SmartMeteo/smartmeteo/artwork/portal_v4.png

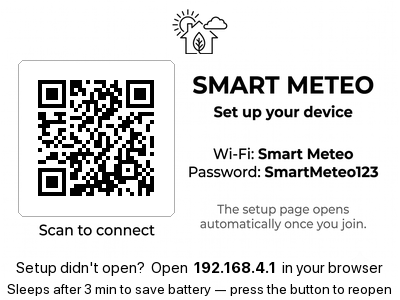
artwork/portal_v4.png
