SmartMeteo/smartmeteo/artwork/weather_v2.png

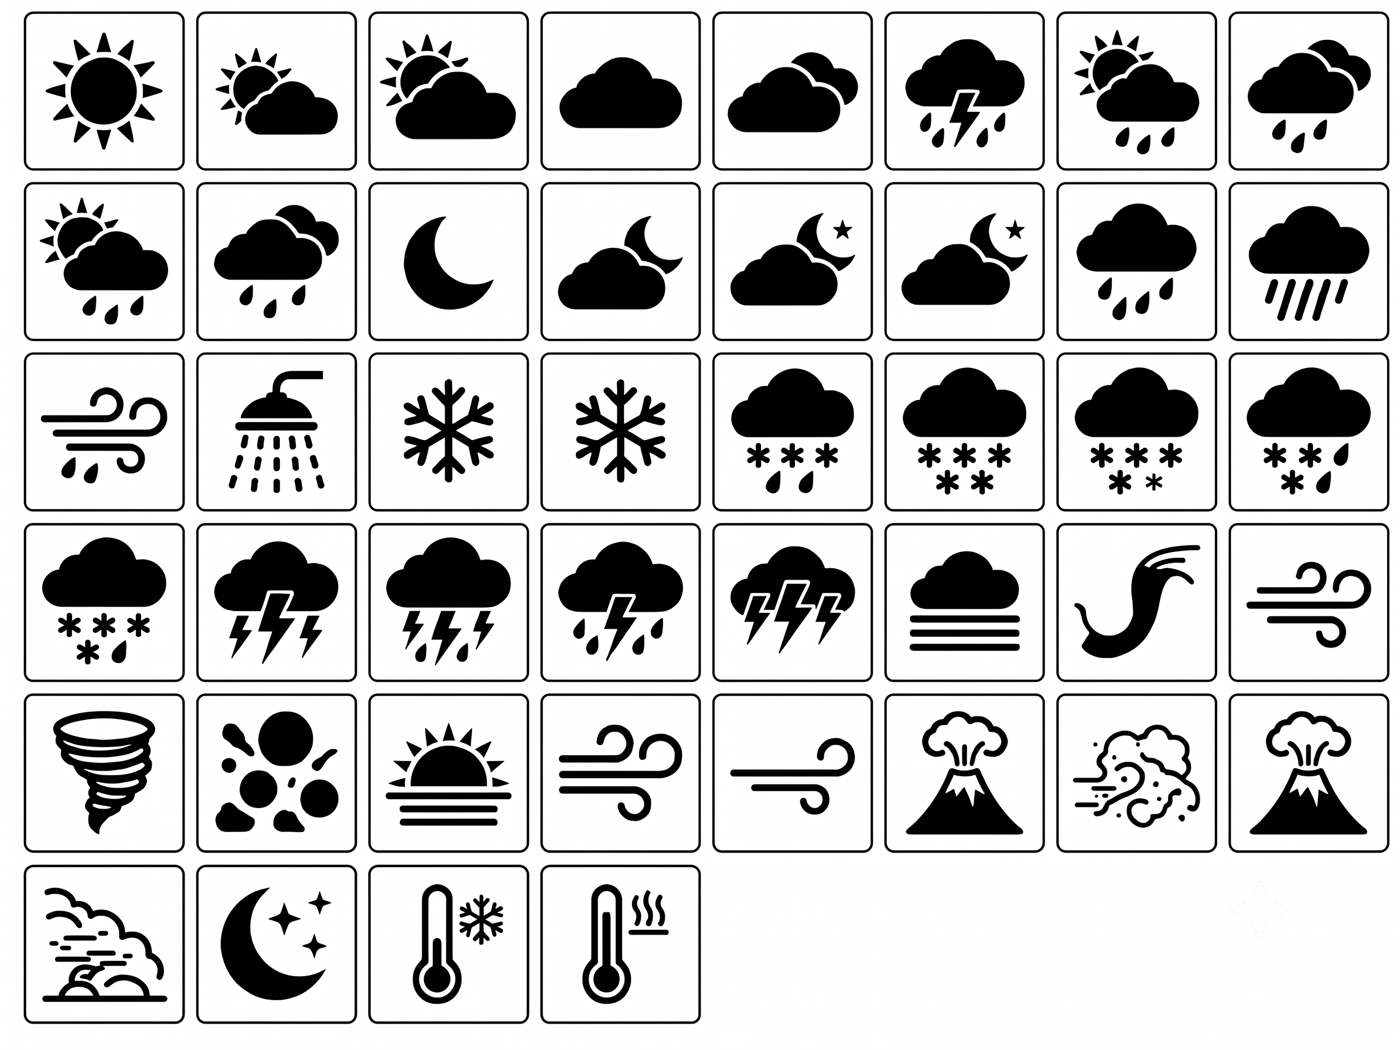
artwork/weather_v2.png
