SmartMeteo/smartmeteo/artwork/wxv2/idx00.png

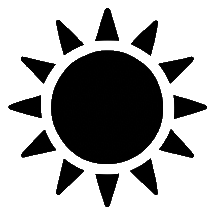
artwork/wxv2/idx00.png
