SmartMeteo/smartmeteo/artwork/wxv2/idx01.png

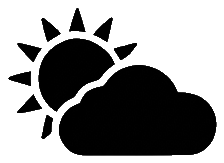
artwork/wxv2/idx01.png
