SmartMeteo/smartmeteo/artwork/wxv2/idx02.png

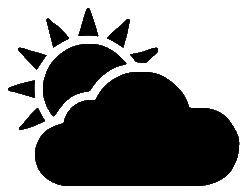
artwork/wxv2/idx02.png
