SmartMeteo/smartmeteo/artwork/wxv2/idx03.png

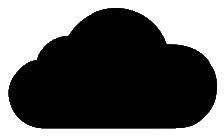
artwork/wxv2/idx03.png
