SmartMeteo/smartmeteo/artwork/wxv2/idx04.png

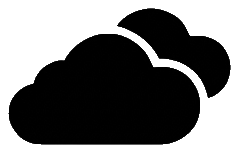
artwork/wxv2/idx04.png
