SmartMeteo/smartmeteo/artwork/wxv2/idx05.png

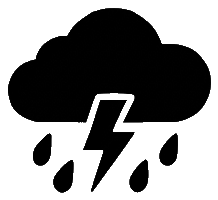
artwork/wxv2/idx05.png
