SmartMeteo/smartmeteo/artwork/wxv2/idx06.png

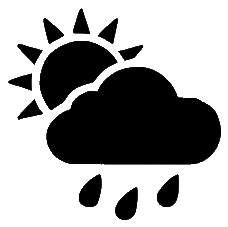
artwork/wxv2/idx06.png
