SmartMeteo/smartmeteo/artwork/wxv2/idx07.png

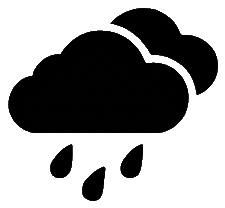
artwork/wxv2/idx07.png
