SmartMeteo/smartmeteo/artwork/wxv2/idx09.png

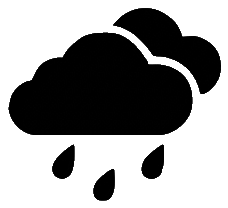
artwork/wxv2/idx09.png
