SmartMeteo/smartmeteo/artwork/wxv2/idx10.png

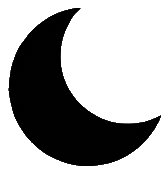
artwork/wxv2/idx10.png
