SmartMeteo/smartmeteo/artwork/wxv2/idx11.png

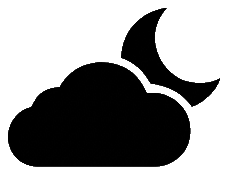
artwork/wxv2/idx11.png
