SmartMeteo/smartmeteo/artwork/wxv2/idx12.png

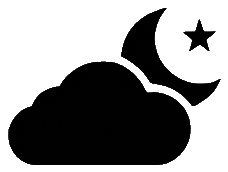
artwork/wxv2/idx12.png
