SmartMeteo/smartmeteo/artwork/wxv2/idx14.png

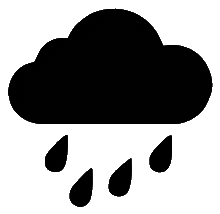
artwork/wxv2/idx14.png
