SmartMeteo/smartmeteo/artwork/wxv2/idx15.png

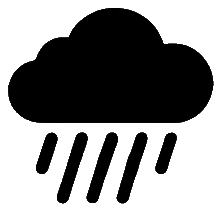
artwork/wxv2/idx15.png
