SmartMeteo/smartmeteo/artwork/wxv2/idx16.png

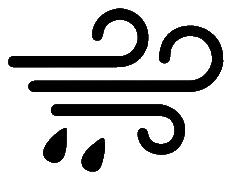
artwork/wxv2/idx16.png
