SmartMeteo/smartmeteo/artwork/wxv2/idx17.png

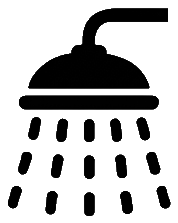
artwork/wxv2/idx17.png
