SmartMeteo/smartmeteo/artwork/wxv2/idx18.png

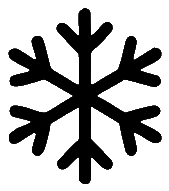
artwork/wxv2/idx18.png
