SmartMeteo/smartmeteo/artwork/wxv2/idx20.png

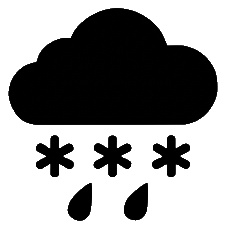
artwork/wxv2/idx20.png
