SmartMeteo/smartmeteo/artwork/wxv2/idx25.png

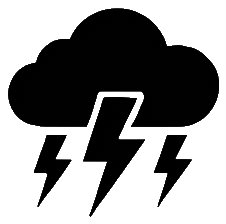
artwork/wxv2/idx25.png
