SmartMeteo/smartmeteo/artwork/wxv2/idx26.png

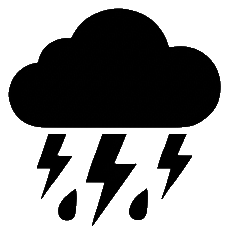
artwork/wxv2/idx26.png
