SmartMeteo/smartmeteo/artwork/wxv2/idx28.png

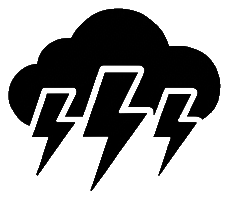
artwork/wxv2/idx28.png
