SmartMeteo/smartmeteo/artwork/wxv2/idx29.png

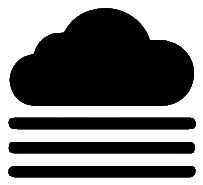
artwork/wxv2/idx29.png
