SmartMeteo/smartmeteo/artwork/wxv2/idx30.png

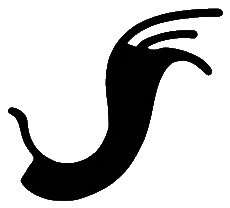
artwork/wxv2/idx30.png
