SmartMeteo/smartmeteo/artwork/wxv2/idx31.png

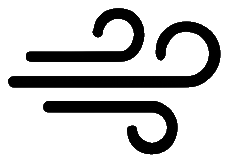
artwork/wxv2/idx31.png
