SmartMeteo/smartmeteo/artwork/wxv2/idx32.png

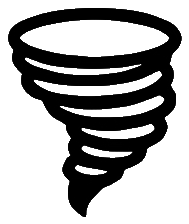
artwork/wxv2/idx32.png
