SmartMeteo/smartmeteo/artwork/wxv2/idx33.png

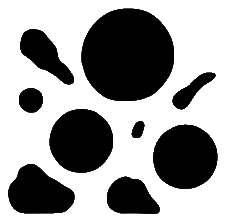
artwork/wxv2/idx33.png
