SmartMeteo/smartmeteo/artwork/wxv2/idx34.png

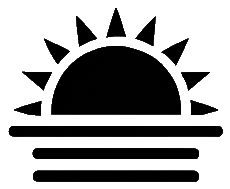
artwork/wxv2/idx34.png
