SmartMeteo/smartmeteo/artwork/wxv2/idx35.png

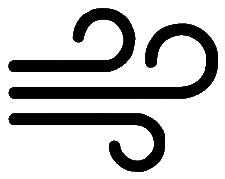
artwork/wxv2/idx35.png
