SmartMeteo/smartmeteo/artwork/wxv2/idx36.png

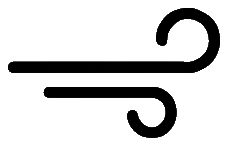
artwork/wxv2/idx36.png
