SmartMeteo/smartmeteo/artwork/wxv2/idx37.png

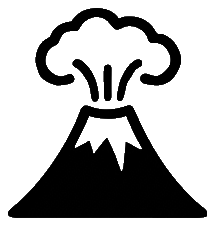
artwork/wxv2/idx37.png
