SmartMeteo/smartmeteo/artwork/wxv2/idx38.png

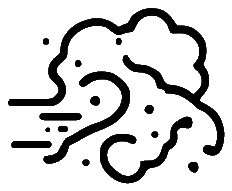
artwork/wxv2/idx38.png
