SmartMeteo/smartmeteo/artwork/wxv2/idx40.png

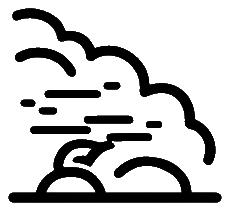
artwork/wxv2/idx40.png
