SmartMeteo/smartmeteo/artwork/wxv2/idx41.png

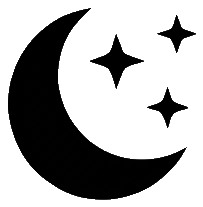
artwork/wxv2/idx41.png
