SmartMeteo/smartmeteo/artwork/wxv2/idx42.png

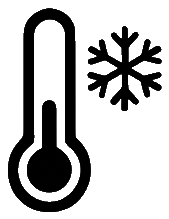
artwork/wxv2/idx42.png
