SmartMeteo/smartmeteo/artwork/wxv2/idx43.png

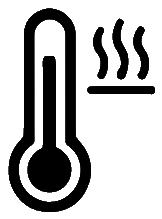
artwork/wxv2/idx43.png
