SmartMeteo/smartmeteo/hardware/board-v2/SmartMeteo-v2.2_BOM.csv

ID | Name | Designator | Footprint | Quantity | Manufacturer Part | Manufacturer | Supplier | Supplier Part | Price
1 | HX TS-1088-AR02016 | BOOT,RESET | SW-SMD_L4.0-W2.9-LS5.0 | 2 | HX 3x4x2-2P-2.5N | hanxia(韩下) | LCSC | C36498961 | 0.026
2 | 1uF | C1,C4,C6,C7,C23,C24,C25,C27,C28,C29,C30,C31 | C0805 | 12 | CL21B105KBFNNNE | SAMSUNG(三星) | LCSC | C28323 | 0.043
3 | 10uF | C2,C3,C5,C19,C20 | C0805 | 5 | CL21A106KAYNNNE | SAMSUNG(三星) | LCSC | C15850 | 0.04
4 | 22pF | C8,C11 | C0805 | 2 | CL21C220JBANNNC | SAMSUNG(三星) | LCSC | C1804 | 0.012
5 | 100nF | C9,C10 | C0805 | 2 | CC0805KRX7R9BB104 | YAGEO(国巨) | LCSC | C49678 | 0.021
6 | 4.7uF | C21,C33 | C0805 | 2 | CL21A475KAQNNNE | SAMSUNG(三星) | LCSC | C1779 | 0.035
7 | 22uF | C32 | C0805 | 1 | CL21A226MAQNNNE | SAMSUNG(三星) | LCSC | C45783 | 0.185
8 | S2B-PH-SM4-TB(LF)(SN) | CN1 | CONN-SMD_P2.00_S2B-PH-SM4-TB-LF-SN | 1 | S2B-PH-SM4-TB(LF)(SN) | JST | LCSC | C295747 | 0.228
9 | PESD5V0S1BA,115 | D1 | SOD-323_L1.7-W1.3-LS2.5-BI | 1 | PESD5V0S1BA,115 | Nexperia(安世) | LCSC | C19224 | 0.074
10 | TPD2E009DBZR_C2871371 | D2 | SOT-23-3_L2.9-W1.3-P1.90-LS2.4-BR | 1 | TPD2E009DBZR | TI(德州仪器) | LCSC | C2871371 | 0.318
11 | B5819W_C8598 | D3,D4,D5,D6 | SOD-123_L2.7-W1.6-LS3.7-RD-1 | 4 | B5819W SL | CJ(江苏长电/长晶) | LCSC | C8598 | 0.027
12 | 47uH | L1 | IND-SMD_L4.5-W4.0 | 1 | CD43-470M 47UH | DMBJ(振宝佳) | LCSC | C2826648 | 0.036
13 | 0805G (Green) | LED1 | LED0805-R-RD | 1 | KT-0805G | KENTO | LCSC | C2297 | 0.017
14 | 17-21SUYC/TR8 | LED2 | LED0805-R-RD | 1 | KT-0805黄灯 | KENTO | LCSC | C2296 | 0.013
15 | FPC 0.5MM 24P Pull type H2.0mm Pick up | P2 | FPC-SMD_24P-L17.5-W5.4-P0.50 | 1 | AFC07-S24ECC-00 | JS(钜硕电子) | LCSC | C11092 | 0.098
16 | AO3400A | Q1,Q2 | SOT-23-3_L2.9-W1.3-P1.90-LS2.4-BR | 2 | AO3400A | AOS | LCSC | C20917 | 0.09
17 | AO3401A | Q3,Q4 | SOT-23_L2.9-W1.3-P1.90-LS2.4-BR | 2 | AO3401A | AOS | LCSC | C15127 | 0.084
18 | XC6220B331MR-G | Q5 | SOT-25_L3.0-W1.6-P0.95-LS2.8-TL | 1 | XC6220B331MR-G | TOREX(特瑞仕) | LCSC | C86534 | 0.48
19 | 5.1kΩ | R1,R5 | R0805 | 2 | 0805W8F5101T5E | UNI-ROYAL(厚声) | LCSC | C27834 | 0.006
20 | 22Ω | R2,R4 | R0805 | 2 | 0805W8F220JT5E | UNI-ROYAL(厚声) | LCSC | C17561 | 0.005
21 | 4.7kΩ | R3,R22 | R0805 | 2 | 0805W8F4701T5E | UNI-ROYAL(厚声) | LCSC | C17673 | 0.004
22 | 10kΩ | R6,R10,R11,R14,R15,R16,R21 | R0805 | 7 | 0805W8F1002T5E | UNI-ROYAL(厚声) | LCSC | C17414 | 0.003
23 | 1.2kΩ | R7 | R0805 | 1 | 0805W8F1201T5E | UNI-ROYAL(厚声) | LCSC | C17379 | 0.005
24 | 100kΩ | R8 | R0805 | 1 | 0805W8F1003T5E | UNI-ROYAL(厚声) | LCSC | C149504 | 0.006
25 | 1MΩ | R9,R17 | R0805 | 2 | 0805W8F1004T5E | UNI-ROYAL(厚声) | LCSC | C17514 | 0.004
26 | 390kΩ | R12 | R0805 | 1 | RT0805BRD07390KL | YAGEO(国巨) | LCSC | C865444 | 0.044
27 | 1kΩ | R18,R20 | R0805 | 2 | 0805W8F1001T5E | UNI-ROYAL(厚声) | LCSC | C17513 | 0.004
28 | 2.2Ω | R19 | R0805 | 1 | 0805W8F220KT5E | UNI-ROYAL(厚声) | LCSC | C17521 | 0.006
29 | 1MΩ | R23 | R0805 | 1 | RT0805BRD071ML | YAGEO(国巨) | LCSC | C706228 | 0.073
30 | GT-TC018A-H0375-L1 | SW2 | SW-SMD_L4.7-W3.5-P3.35-EH | 1 | GT-TC018A-H0375-L1 | G-Switch(品赞) | LCSC | C963235 | 0.063
31 | SCD41-D-R2 | U3 | LGA-20_L10.1-W10.1-P1.25-TL | 1 | SCD41-D-R2 | Sensirion(瑞士盛思锐) | LCSC | C3659294
32 | M2 INSERT 4MM | U5,U7,U12,U13 | M2 4MM SMT INSERT | 4 | SMTSO2040CTJ | Sinhoo(雄和远景) | LCSC | C2916349 | 0.088
33 | ESP32-C6-WROOM-1-N8 | U6 | WIRELM-SMD_ESP32-C6-WROOM-1 | 1 | ESP32-C6-WROOM-1-N8 | ESPRESSIF(乐鑫) | LCSC | C5366877 | 4.34
34 | TP4056 | U8 | ESOP-8_L4.9-W3.9-P1.27-LS6.0-BL-EP | 1 | TP4056-42-ESOP8 | TOPPOWER(南京拓微) | LCSC | C16581 | 0.187
35 | 3.7V 2000MAH 54×35 | U9 | LIPO-103450_2000MAH_54X35 | 1 |  |  | aliexpress
36 | BME690 | U10 | LGA-8_L3.0-W3.0-P0.80-TR-1 | 1 | BME690 | Bosch(博世) | LCSC | C42431867 | 10.012
37 | HX TYPE-C 16PIN | U11 | TYPE-C-SMD_HX-TYPE-C-16PIN | 1 | HX TYPE-C 16PIN | hanxia(韩下) | LCSC | C5178539 | 0.076
38 | 32.768kHz | X1 | FC-135R_L3.2-W1.5 | 1 | Q13FC13500004 | EPSON(爱普生) | LCSC | C32346 | 0.173
