SmartMeteo/smartmeteo/hardware/enclosure/release_v2.2/pla/stl/stand_flap.stl

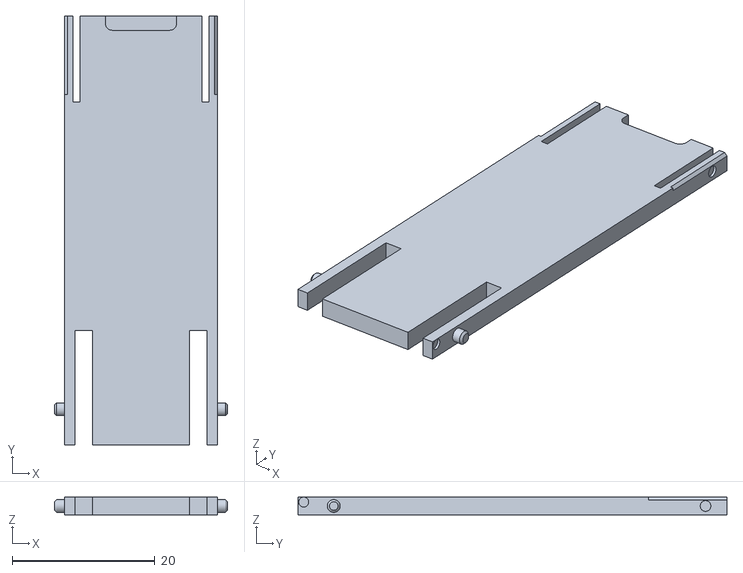
[picture p40: CAD file, 2026-11-04]
hardware/enclosure/release_v2.2/pla/stl/stand_flap.stl
24.2 x 60.0 x 2.50
