SmartMeteo/smartmeteo/hardware/enclosure/release_v2.2/pla/stl/key.stl

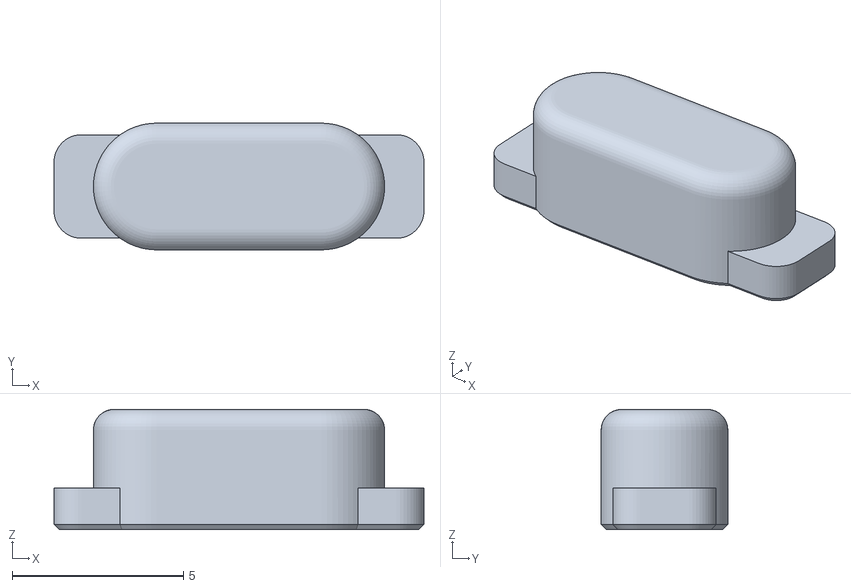
[picture p42: CAD file, 2026-11-04]
hardware/enclosure/release_v2.2/pla/stl/key.stl
10.8 x 3.70 x 3.51
