SmartMeteo/smartmeteo/hardware/enclosure/release_v2.2/pla/stl/front_shell.stl

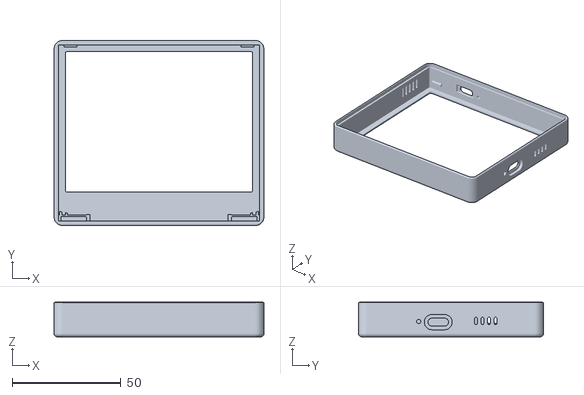
[picture p44: CAD file, 2026-11-04]
hardware/enclosure/release_v2.2/pla/stl/front_shell.stl
96.4 x 84.9 x 15.9
