SmartMeteo/smartmeteo/hardware/enclosure/release_v2.2/sla/step/rear_cover.step

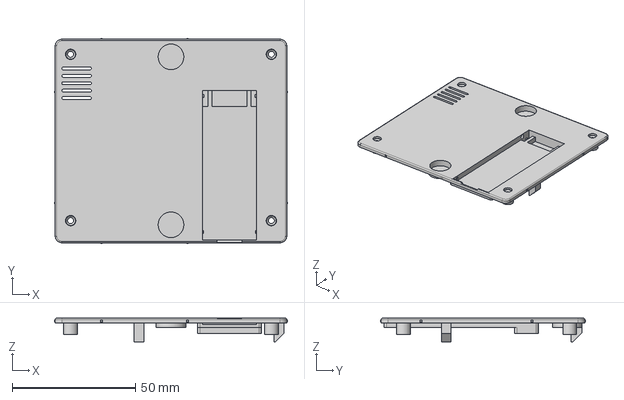
[picture p45: CAD file, 2026-11-04]
hardware/enclosure/release_v2.2/sla/step/rear_cover.step
94.5 x 83.1 x 9.69 mm
