SmartMeteo/smartmeteo/hardware/enclosure/release_v2.2/pla/stl/jig_base.stl

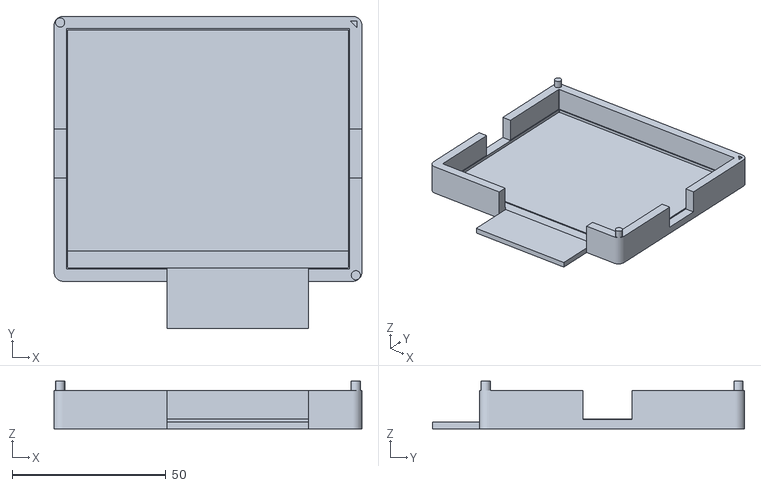
[picture p46: CAD file, 2026-11-04]
hardware/enclosure/release_v2.2/pla/stl/jig_base.stl
100.2 x 101.6 x 15.6
