SmartMeteo/smartmeteo/hardware/enclosure/release_v2.2/sla/step/key_c030.step

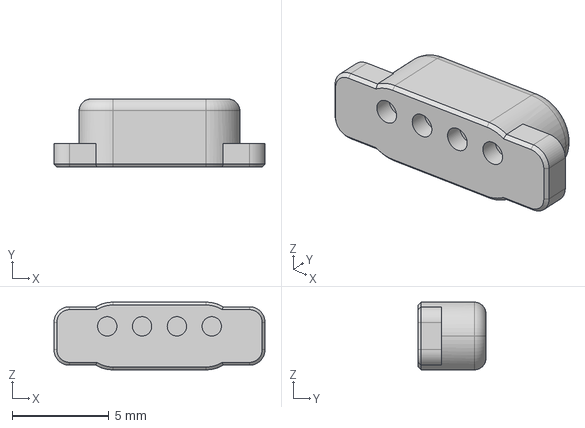
[picture p47: CAD file, 2026-11-04]
hardware/enclosure/release_v2.2/sla/step/key_c030.step
10.9 x 3.51 x 3.50 mm
