SmartMeteo/smartmeteo/hardware/enclosure/release_v2.2/pla/stl/rear_cover.stl

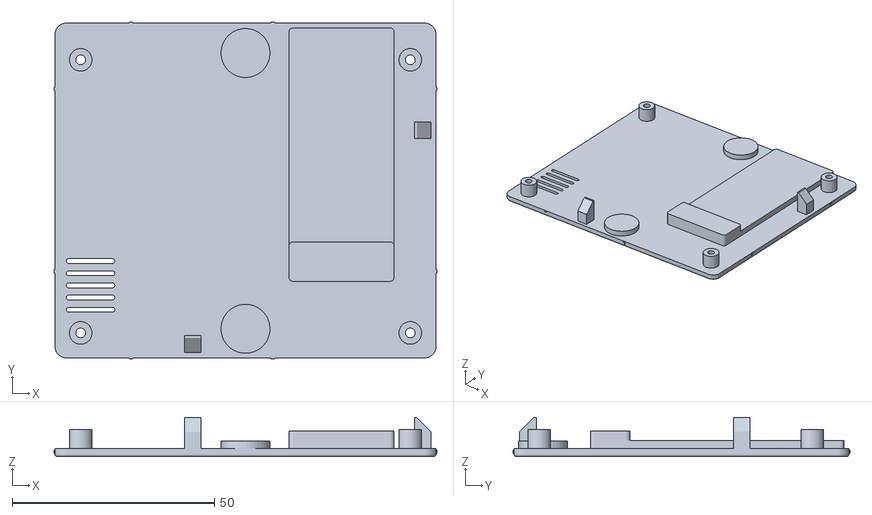
[picture p48: CAD file, 2026-11-04]
hardware/enclosure/release_v2.2/pla/stl/rear_cover.stl
94.6 x 83.1 x 9.69
