SmartMeteo/smartmeteo/hardware/enclosure/release_v2.2/pla/stl/jig_lid.stl

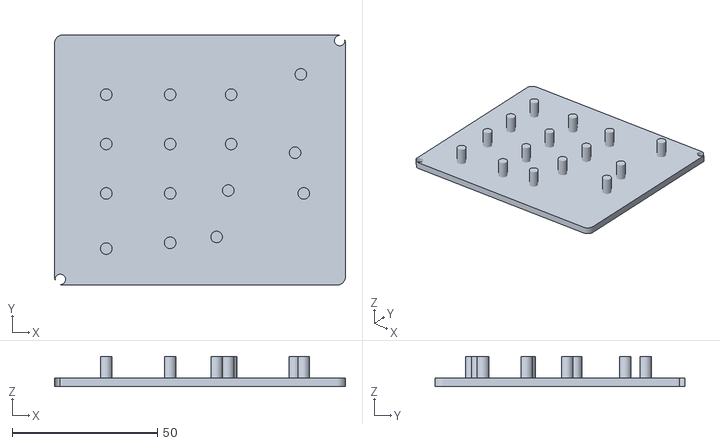
[picture p49: CAD file, 2026-11-04]
hardware/enclosure/release_v2.2/pla/stl/jig_lid.stl
100.2 x 86.2 x 10.4
