SmartMeteo/smartmeteo/hardware/enclosure/release_v2.2/sla/step/key_c025.step

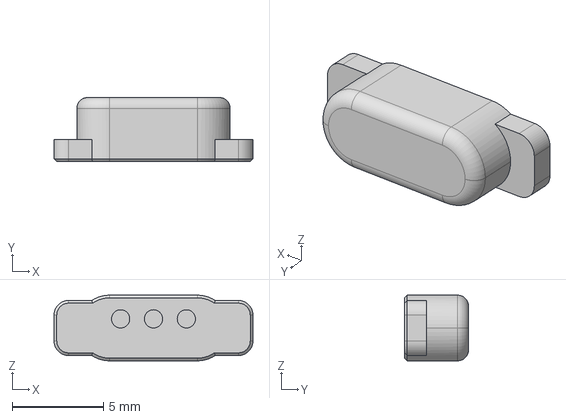
[picture p50: CAD file, 2026-11-04]
hardware/enclosure/release_v2.2/sla/step/key_c025.step
10.9 x 3.51 x 3.60 mm
