SmartMeteo/smartmeteo/(list of files, cad)

Other CAD files:
hardware/enclosure/release_v2.2/sla/step/key.step
hardware/enclosure/release_v2.2/sla/step/stand_flap.step
hardware/enclosure/release_v2.2/sla/step/front_shell.step
hardware/enclosure/release_v2.2/sla/stl/front_shell.stl
hardware/enclosure/release_v2.2/sla/stl/key.stl
hardware/enclosure/release_v2.2/sla/stl/key_c010.stl
hardware/enclosure/release_v2.2/sla/stl/key_c015.stl
hardware/enclosure/release_v2.2/sla/stl/key_c025.stl
hardware/enclosure/release_v2.2/sla/stl/key_c030.stl
hardware/enclosure/release_v2.2/sla/stl/rear_cover.stl
hardware/enclosure/release_v2.2/sla/stl/stand_flap.stl
