SmartMeteo/smartmeteo/firmware/tests/README.md

# Автотесты Smart Meteo

Одной командой, без ESP-IDF и без прибора:

```bash
Software/ESP-IDF/tests/run.sh
```

Нужны `c++` (Apple clang) и `python3`; для браузерного набора — node и playwright (ниже). Проверки
собирают **исходники прошивки**, а не их копии: если тест расходится с прибором, значит изменился
прибор.

## Что проверяется

| Набор | Что именно | Как |
|---|---|---|
| `t_analytics` | классы Bosch и их границы, каскад `classifyAir`, гистерезис CO₂ и влажности, точка росы, пороги тенденции Met Office, уровни тревог | компилирует настоящий `analytics.cpp` |
| `t_weather` | таблица символов MET, разбор дат и заголовка `Expires`, сводка по дням, выбор иконки, **весь путь `Weather::met`** на подставленном ответе | компилирует `weather.cpp` целиком, сеть заменена на уровне ESP-IDF |
| `t_cycle` | **расписание пробуждений**: профили и их интервалы, ночное окно через полночь, прибор без сети, пол радио в режиме хаба, ночная парковка панели и правило «замораживающий кадр обязан быть полным», слепой режим без часов, чистящий кадр, опережение к границе минуты, блокировка по разряду и выход из неё на кабеле, снятие источников сна, **оборот кольца истории** — код, не исполнявшийся ни на одном приборе | компилирует **настоящий `bench_screens.cpp`** с заглушками ESP-IDF под ним |
| `t_screen` | десять состояний экрана против утверждённого снимка + инварианты (доля чернил, пароль втрое выше адреса) | `tools/screenhost` — это `screen.cpp` и `epaper.cpp` прибора |
| `t_console` | синтаксис скрипта консоли; каждый путь консоли есть в прошивке и наоборот; **каждый закрытый обработчик спрашивает пароль**; одно правило длины пароля на все места; картинки гида; шаги мастера | разбор `console.html`, `web_server.cpp`, `wifi_manager.*` |
| `t_browser` | вход по паролю, все вкладки, журнал безопасности, гид, мастер целиком; **вёрстка на 320 / 360 / 375 / 1024 px, в том числе на предельных данных**; ни одного исключения в скрипте | настоящий Chromium против `tests/mock.py` |

Итог сейчас: **584 проверки C++** (54 аналитика, 69 погода, 44 экран настройки, 298 солнце и луна,
119 цикл) плюс сверка солнца со второй реализацией, **41 по экрану** (снимки и инварианты),
**179 по консоли**, **129 в браузере** — 933 всего.

## Как это устроено

**Заглушки — под кодом прошивки, а не вместо него.** `stubs/` подменяет заголовки ESP-IDF
(`esp_log.h`, `esp_timer.h`, `esp_http_client.h`), поэтому `Https::Reader` и потоковый разбор —
настоящие. Тело ответа задаёт `HttpStub::body`; `HttpStub::chunk` выдаёт его кусками по N байт, и
разбор, который зависит от границ чтения, падает здесь, а не на приборе.

Заглушать `main/https_client.h` бесполезно: `#include "..."` в кавычках сначала смотрит рядом с
включающим файлом, поэтому настоящий заголовок всё равно побеждает. Это и правильно — подменять
стоит чужой код, а не свой.

### Расписание пробуждений: `t_cycle`

`bench_screens.cpp` был крупнейшим файлом проекта и единственным крупным, которого не касался ни
один тест. Причина уважительная: сон, радио, шину I²C и панель заменить нечем, кроме прибора. Но
**решение отделимо от исполнения** — что мерить, когда выходить в сеть, будет ли кадр полным, на
какой срок засыпать — это арифметика над настройками, часами и состоянием RTC, и она проверяется
здесь.

Заглушки стоят **под** прошивкой, на границе ESP-IDF (`stubs/idf/`), поэтому настоящими остаются не
только четыре функции расписания, но и почти вся прошивка: `nvs_manager.cpp` над эмуляцией NVS
(включая хранение float битовым образом U32), `hist_store.cpp` и `evt_log.cpp` над флешем в ОЗУ,
который умеет только сбрасывать биты — как настоящий, `analytics.cpp`, `sun_moon.cpp`, `screen.cpp`,
`epaper.cpp`, `max17048.cpp` над эмуляцией регистров газомера.

Заглушены на границе **класса** только три, и у каждого причина: `WebServer` и `MqttPublisher` —
выходы цикла, уже покрытые `t_console` и `t_browser`; `MatterMode` — за ним CHIP, которого на этой
машине нет, и он всё равно не уходит в глубокий сон. Отдельно заглушён закрытый алгоритм Bosch
(`libalgobsec.a` собрана под RISC-V) — но **под** настоящим `bsec_manager.cpp`, так что порядок
инициализации, вентиль по `next_call` и арифметика метки времени исполняются как на приборе.

Прошивка для этого **не менялась ни на строку**. Часы перехвачены определением `time()` и
`gettimeofday()` в `stubs/idf/host.cpp`; выход из сна и перезагрузки — броском `HostDeepSleep` и
`HostRestart`. Это тот же класс приёма, что `-Dprivate=public` в `tools/screenhost`.

Чем тест управляет и что читает — `stubs/idf/host.h`: часы, кабель, кнопка, напряжение ячейки,
свободная куча, причина загрузки; обратно — какой таймер вооружён, снимались ли источники, сколько
раз позван `esp_restart()`, и **захваченный лог**, потому что часть решений прошивки видна только в
нём.

**Чего `t_cycle` не проверяет:** что прибор действительно проснулся, что панель действительно
нарисовала, что радио действительно подключилось, и сходится ли индекс Bosch. Это прогон на железе.
Здесь проверяется, что прошивка **решила**, а не что получилось.

**Одно расхождение с прибором, по построению:** на приборе каждое пробуждение — новая загрузка, и
функциональные статики начинаются заново; здесь все случаи идут в одном процессе. В функциях под
проверкой такая одна — `static bool asked` в `plan_tick()`. Ни одна проверка на неё не опирается.

**Санитайзеры включены** (`-fsanitize=address,undefined`). Разбор чужого ответа — ровно то место,
где чтение за буфером стоит ловить на компьютере.

**Снимки экрана** лежат в `golden/*.pbm` (по 15 КБ, открываются просмотрщиком). При расхождении тест
печатает число разошедшихся пикселей и их область. Принять новый вид — **посмотрев на него**:

```bash
Software/ESP-IDF/tests/run.sh --accept
```

**Подставной прибор** — `tests/mock.py`: тот же веб-API, та же аутентификация вызов-ответ и те же
заголовки, что шлёт прошивка. Он отдаёт **настоящий** `main/console.html`, а не копию: копия
разошлась бы с прошивкой в первый же день, и тест начал бы проверять вчерашнюю страницу. Его можно
поднять и руками, чтобы посмотреть самому:

```bash
Software/ESP-IDF/tests/mock.py
```

Пароль печатается при запуске; `/stress?on=1` включает предельные данные (длинные имена, 12345 ppm,
−40,5 °C), `/mock?setup=1` возвращает прибор в ненастроенное состояние, `/mock/saves` показывает, что
страница сохранила.

**Снимки консоли для гида на сайте** делаются настоящей консолью, а не рисуются:

```bash
node tests/shot_console.js stripCard /tmp/c_strip.png
```

Тот же подставной прибор и тот же браузер, что у `t_browser`; снимается один элемент живой
страницы. Рисованный снимок разошёлся бы с консолью в первый же день, а лежит он на публичной
странице. Кадры экрана для гида — из `tools/screenhost` по той же причине.

**Браузерный набор посмотреть своими глазами:**

```bash
node Software/ESP-IDF/tests/t_browser.js --headed
```

## Если браузерного набора нет

`run.sh` пропускает его с объяснением, а не с провалом — на машине без node остальные четыре слоя
работают. Поставить (без прав администратора, Homebrew не нужен):

```bash
mkdir -p ~/.local && cd ~/.local && curl -sSO https://nodejs.org/dist/v24.21.0/node-v24.21.0-darwin-arm64.tar.xz && curl -sS https://nodejs.org/dist/v24.21.0/SHASUMS256.txt | grep darwin-arm64.tar.xz | shasum -a 256 -c - && tar -xf node-v24.21.0-darwin-arm64.tar.xz && mv node-v24.21.0-darwin-arm64 node && rm node-v24.21.0-darwin-arm64.tar.xz
```

Сумму сверяем не для порядка: этот архив потом запускает код на машине, где лежит ключ подписи
прошивок.

```bash
export PATH="$HOME/.local/node/bin:$PATH" && cd "Software/ESP-IDF/tests" && npm i playwright && npx playwright install chromium
```

Движок (~94 МБ) ложится в `~/Library/Caches/ms-playwright`, `node_modules` не коммитится.

## Чего здесь нет

**Прибора.** Сон, пробуждение, радио, I²C и панель проверяются только на железе — ни один слой этого
не заменяет.

## Как добавить проверку

- C++: новый `t_имя.cpp` рядом, `#include "check.h"`, строка в `run.sh`. Набор включает нужный
  `.cpp` прошивки прямо в себя — так тест дотягивается до статических функций, не проделывая в
  прошивке дырку ради теста.
- Состояние экрана: ветка в `tools/screenhost/main.cpp`, имя в `STATES` внутри `t_screen.py`,
  затем `run.sh --accept`.
- Браузер: в `t_browser.js` рядом с остальными. Новый ответ API — в `mock.py`; если страница
  запрашивает путь, которого там нет, `t_console` заметит это раньше браузера.
