SmartMeteo/smartmeteo/firmware/tests/stubs/idf/README.md

ESP-IDF, ровно настолько, чтобы `main/bench_screens.cpp` собрался на этой машине.

Заглушки стоят **под** прошивкой, на границе ESP-IDF — тот же приём, что у `t_weather` с
`esp_http_client.h`. Поэтому `readPlan()`, `plan_tick()`, `time_to_next_wake()` и
`battery_too_low()` здесь настоящие, и настоящий же `nvs_manager.cpp` над эмуляцией NVS: путь
настроек, включая хранение float битовым образом U32, исполняется как на приборе.

Каталог свой, а не общий `tests/stubs/`, чтобы правка здесь не могла ничего изменить у
`t_weather` и `t_portal`: только `t_cycle` собирается с `-I stubs/idf`.

Что можно задавать из теста — `host.h`. Всё остальное отвечает «получилось» и ничего не делает:
прошивке нужно слинковаться, а не поработать.
