SmartMeteo/smartmeteo/hardware/board-v2/SmartMeteo-v2.2_schematic.pdf

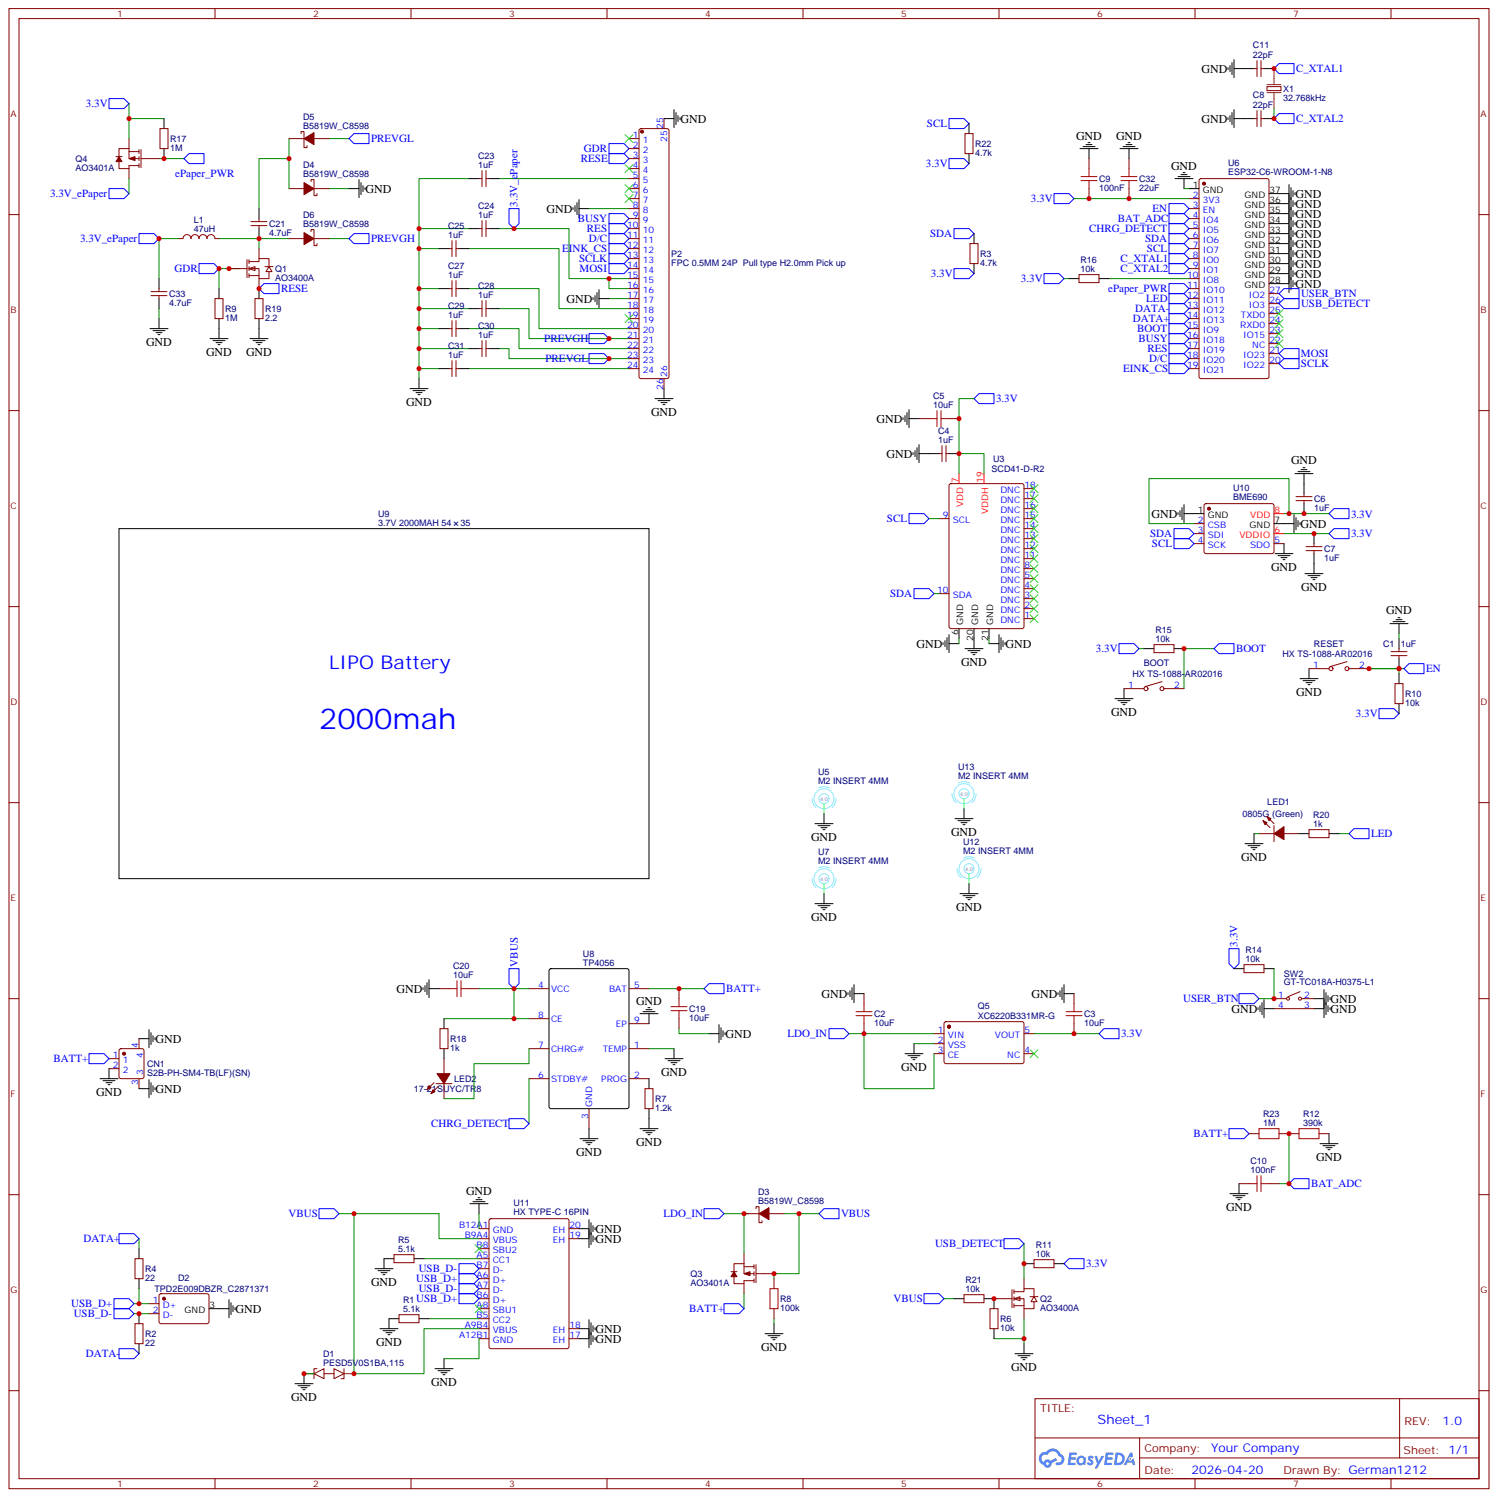
[picture p51: page 1]
