SmartMeteo/smartmeteo/firmware/main/bench_screens.cpp

// ============================================================================
// SETUP CYCLE — the panel, the access point, the web console and deep sleep.
//
//   press the button:
//     * Wi-Fi NOT configured yet -> AP up, web console up, QR SETUP on the glass,
//                                   3 minutes to complete the wizard
//     * Wi-Fi already configured -> AP up, web console up, QR SETUP on the glass,
//                                   3 minutes to change anything
//   then, either way: radio down -> LOGO back on the glass -> deep sleep.
//
// The window restarts on every web request, so someone filling in the wizard is never cut off;
// a short press ends it early. The LED answers every press: two blinks to acknowledge it, lit
// while the device is working, out just before it sleeps.
//
// Grown one piece at a time from the screens-only bench that worked: pictures, then sleep, then
// the AP, then the button and the LED, and now the web console and the 3-minute window. No
// sensors and no dashboard yet — those are the next pieces.
//
// Everything is logged as FACT, not intent: how long a refresh really took, how much heap is
// free, what woke us. A 4-gray refresh takes about 7 s; anything far below that means the data
// never reached the panel (which is what heap pressure from Wi-Fi does, silently).
// ============================================================================
#include <stdio.h>
#include <stdlib.h>
#include <math.h>
#include <string.h>
#include <ctype.h>
#include <string>
#include "freertos/FreeRTOS.h"
#include "freertos/task.h"
#include "esp_log.h"
#include "esp_sleep.h"
#include "esp_system.h"
#include "fw_version.h"
#include "esp_ota_ops.h"   // reverting to the other slot when this image cannot finish a boot
#include "esp_app_desc.h"   // esp_app_get_description(): version + ELF hash
#include "esp_core_dump.h"  // erasing the dump on factory reset: it holds the owner's SSID
#include "esp_timer.h"
#include "esp_task_wdt.h"
#include "esp_pm.h"
#include "esp_wifi.h"
#include "esp_event.h"
#include "esp_netif.h"
#include "nvs_flash.h"
#include "driver/gpio.h"
#include "soc/rtc.h"        // which slow clock is REALLY running
#include "esp_clk_tree.h"   // LP-domain pad control: the pull that survives deep sleep

#include "bench_screens.h"
#include "epaper.h"
#include "pm_gate.h"
#include "portal_art.h"
#include "logo4g.h"     // picture A: the Smart Meteo logo
#include "portal_screen.h" // picture B: the Wi-Fi setup screen, with this device's QR code and password
#include "lock4g.h"     // picture C: the low-battery lock screen
#include "web_server.h"
#include "captive_dns.h"
#include "mdns.h"
#include "nvs_manager.h"
#include "wifi_manager.h"
#include "esp_heap_caps.h"
#include "i2c_manager.h"
#include "scd41.h"
#include "bme690.h"
#include "bsec_manager.h"
#include "nvs.h"
#include "max17048.h"
#include "battery_monitor.h"
#include "battery_source.h"
#include "battery_spec.h"
#include "co2_alert.h"
#include "units.h"
#include "clock_sync.h"
#include "weather.h"
#include "analytics.h"
#include "telegram.h"
#include <functional>
#include "mqtt_publisher.h"
#include "ota_check.h"
#include "ota_install.h"
#include "ArduinoJson.h"
#include "hist_store.h"
#include "evt_log.h"
#include "screen.h"
#include "sun_moon.h"
#include "matter_mode.h"
#include "freertos/semphr.h"
#include <time.h>
#include <sys/time.h>

static const char *TAG = "SETUP_CYCLE";

#define PORTAL_SEC        180       // how long the setup window stays open with no activity
// The clock tick. Kept at a minute by choice, with the cost written down rather than forgotten.
//
// Measured over 141.7 h on hardware: 6560 partial refreshes against 105 full ones, one update every
// 76 seconds. Good Display asks for no more than one per 180 s on this panel. The owner's Arduino
// device, which has run this same panel in this same room with a clean screen for months, ticks
// every five minutes and so obeys that rule; we do not, and that is the one dimension on which we
// still differ from it (4.70).
//
// Going to 300 was tried and reverted deliberately: the live clock is a feature, and the residue
// is being attacked from the other side first — a faster full refresh, which flashes little enough
// to be run often, and a cleaning frame at night where there was none. If those are not enough,
// the interval is what is left, and this comment is the reason to come back to it.
#define TICK_SEC           60
// WHEN THE PANEL LOSES ITS SUPPLY — settled 2026-09-08, and the answer is "almost never".
//
// The switch itself is harmless. Pulling the battery out of a finished device does not touch the
// image, and the vendor's own reference sequence ends with deep sleep followed by POWER OFF. What
// costs is the TRANSITION. This board has no bleed resistor and no quick output discharge on
// 3.3V_ePaper, so when Q4 opens the few microfarads on the rail drain only through the sleeping
// panel's own 2-5 uA: seconds spent in the region where the controller is neither running nor off.
// One such crossing is free. Fourteen hundred a day is not, and one night of it greyed the
// background — the frame lines and labels, pixels no partial update ever drives, which is the
// proof that this happens BETWEEN frames and not during one.
//
// So the rule is about how often, not about whether:
//
//   RUNNING  — the supply STAYS ON through every sleep. A tick every minute means 1440 crossings a
//              day to save about 1 uA out of some 330. GxEPD2 has no concept of a panel power
//              switch at all, and Watchy redraws e-paper every sixty seconds on a battery without
//              one; both are this exact duty cycle.
//   PARKED   — the supply is CUT, because the device is going away and the picture is final. The
//              logo after a factory reset can sit in a box for months on one crossing, and that is
//              precisely the case the switch was put on the board for. Same for the low-battery
//              notice: drawn once, then hourly wakes that only look for a charger (owner, 2026-09-12).
//
// The parked state has to STAY parked, which is what rtc_panel_powered is for: a wake that draws
// nothing must not turn the panel back on, or a month in a box becomes a crossing every hour
// instead of one. Safe mode deliberately keeps its supply — it redraws every hour, so by this same
// rule it is a running state wearing a static picture, and cutting there would buy nothing.
// How long the controller gets between the sleep command and losing its supply. 2 s is the
// short end of what the panel's maker asked for.
#define PANEL_SETTLE_MS 2000
// How long the switched rail needs to be gone before a wake pin may be armed. The decay was
// measured at about two seconds; the button line is capacitively close enough to hear it.
#define RAIL_QUIET_MS   3000
enum class PanelSleep { Powered, Parked };
// The gas sensor's cadence is NOT a user setting. BSEC's ULP configuration is built around a
// 300-second rhythm, and feeding it anything else stops accuracy from ever accumulating
// (CLAUDE.md 4.6). The Mode tab's interval governs the CO2 sensor, which has no such constraint.
#define GAS_SEC           300
// A minute tick can land a second or two short of the gas period: the stamp is whole seconds and wake
// latency jitters. Without this, such a tick slips a whole minute (20 % late; Bosch allows 6.25 %, AN011
// 3.2). Kept small because BSEC schedules from the call time: a tick N s early waits N s for next_call in
// every later period too, and a two-step heater profile (~3 s) must still fit the 12 s loop.
#define GAS_EARLY_SEC     2
// The 3-hour forecast grid barely moves, but each fetch is a second HTTPS request with its own TLS
// handshake and a 16 KB response. Pulling it every time weather refreshes doubled the cost of a
// radio window for nothing. Today's high/low still track "now" on every refresh through the
// observed temperature; the forecast only has to supply the part of the day still ahead.
#define FORECAST_SEC    10800       // 3 hours
// How fresh the outdoor data must be for a button press to leave the radio alone. OpenWeatherMap
// advises no more than one call per location every ten minutes and refreshes at about that rate,
// so anything younger than this is the same numbers we already have — and raising the radio to
// fetch them again is the most expensive thing a press could do.
#define WX_FRESH_SEC      900       // 15 minutes
// Partial updates leave a faint trace of what they replaced, and it builds up until the whole
// panel reads grey. Only a full refresh clears it.
//
// This used to be counted in wakes (120 x 60 s = 2 h), which was true only while every wake was a
// minute apart. Once the sleep length started following the profile, a wake became 300 s at night
// and the same 120 wakes stretched to TEN HOURS — so a night ran end to end without a single full
// refresh, and the screen was grey by morning. Time is what matters here, so time is what is
// measured; the partial count is a second guard for before the clock is ever set.
// ⚠ DIAGNOSTIC SETTING, deliberately breaking the vendor's rule. Not a configuration choice.
//
// Good Display asks for a full refresh after every 5 partials. Obeying that while the partial path
// is the thing under suspicion has a side effect: the cleaning frame MASKS what is being judged.
// Every five minutes it wipes whatever accumulated, so the glass cannot say whether the vendor
// driver improved the partial update or was merely cleaned often enough to hide it.
//
// So the interval is being walked outwards, one step at a time, until something breaks or nothing
// does:
//   5 partials  (~5 min)  — the vendor's own number, shipped in 0.9.16.
//   1 hour      (~50 partials by day, 12 by night) — 0.9.17. Ran 22 h including a full night;
//                the screen stayed clean. That is the first long stretch in this whole saga with
//                RARE cleaning that did not degrade, and rare cleaning is precisely what used to
//                expose the fault.
//   3 hours     (~180 partials by day, 36 by night) — here. Thirty-six times the vendor's limit.
//
// THE EXPERIMENT IS OVER — back to one hour (owner's decision 2026-09-30). Three hours held without
// ghosting, so the question it was asked to answer is answered: the partial path is sound and the
// old ghosting belonged to the driver that was deleted. Knowing that, the interval is no longer a
// probe but a product setting, and an hour is the one that ran 22 hours clean in 0.9.17 while
// staying far closer to what Good Display asks for.
//
// The cost, from measured numbers rather than a guess: a cleaning frame is 1929 ms against 677 ms
// for a partial, so each one costs 1.25 s extra. Eight a day becomes twenty-four — 20 s a day of
// panel time, 0.22 mAh, 1.6 % of the measured 13.66 mAh/day budget, about two days off the life.
//
// Still twelve times the vendor's own limit (a full frame every 5 partials), and that is deliberate:
// their number is written for panels refreshed continuously, and this one sleeps between frames.
//
// Driven by the WALL CLOCK, not the count, because the same count means one hour by day and five at
// night. The count is the fallback for a device with no clock, set to match.
#define FULL_EVERY_SEC   3600       // one hour between cleaning frames, day and night
#define FULL_EVERY_PARTIALS 60      // fallback without a clock: one hour of minute ticks

// The panel's working temperature. Its datasheet allows 0..+50 C; the lower end is kept a couple of
// degrees inside that, because the reading is the room's rather than the film's own and they differ
// by a degree or two near a window. Outside this band the controller has no waveform that finishes.
#define INK_MIN_C  2.0f
#define INK_MAX_C  50.0f
#define EPD_BUSY_PIN      GPIO_NUM_18
#define PIN_USER_BTN      GPIO_NUM_2    // LP-capable, so it can wake the chip from deep sleep
#define PIN_LED           GPIO_NUM_11
#define PIN_USB_DETECT    GPIO_NUM_3    // low = cable in; honest on this board revision
// The setup screen's QR code is made from the same name and password the access point uses.
#define BENCH_AP_SSID     PORTAL_AP_SSID

// Cycle bookkeeping. RTC_NOINIT survives deep sleep AND esp_restart (the wizard ends with one);
// only a real power loss clears it, which the magic below catches.
#define CYC_MAGIC 0x5C0FFEE1
RTC_NOINIT_ATTR static uint32_t rtc_ls_notes;      // light-sleep notes written by this image
RTC_NOINIT_ATTR static uint32_t rtc_pre_notes;     // wake-prologue notes written by this image
RTC_NOINIT_ATTR static uint32_t rtc_magic;

// Does a reading in RTC belong to THIS build? Every variable moves on an over-the-air update, so
// a field that "survived" is really some other variable's old bytes — and the dangerous ones are
// those that land on a plausible value instead of an obvious absurdity. The marker above is what
// vouches for the layout.
//
// start_cycle_from_scratch() clears these for the working cycle and for Matter. The unconfigured
// path never calls it, which is how an ambient pressure of 1.47e21 Pa reached the CO2 sensor on a
// freshly flashed board (seen in the log, 2026-09-29). The range check inside scd41.cpp caught
// that one — but it only rejects the absurd, and the run-up it feeds ends in a FORCED
// RECALIBRATION, which writes a baseline into the sensor's own EEPROM and keeps it through a
// factory reset. A wrong-but-plausible pressure there would be baked in for good.
static inline bool rtc_readings_are_ours(void) { return rtc_magic == CYC_MAGIC; }
RTC_NOINIT_ATTR static uint32_t rtc_tick;          // wake counter, drives the 5-minute cadence
RTC_NOINIT_ATTR static int64_t  rtc_bsec_ns;       // BSEC's virtual clock, advanced over sleep too
RTC_NOINIT_ATTR static int64_t  rtc_bsec_wall_us;  // wall clock (us) that rtc_bsec_ns corresponds to
RTC_NOINIT_ATTR static time_t   rtc_last_weather;  // last SUCCESSFUL fetch (drives the freshness tag)
RTC_NOINIT_ATTR static time_t   rtc_last_wx_try;   // last ATTEMPT — schedules the radio window
RTC_NOINIT_ATTR static time_t   rtc_last_fc;       // last forecast pull
// MET Norway's Expires for the last answer: its terms ask for no request before it.
RTC_NOINIT_ATTR static time_t   rtc_met_expires;
RTC_NOINIT_ATTR static time_t   rtc_last_meas;    // when the gas sensor last ran (fixed 300 s)
RTC_NOINIT_ATTR static time_t   rtc_last_co2;     // when the CO2 sensor last ran (profile interval)
// When the history ring last got a record. Its step is a setting now (NVS "h_step", 5/10/15 min,
// owner 2026-09-16), no longer the gas period by accident.
RTC_NOINIT_ATTR static time_t   rtc_last_hist;
// A console session asked for from Matter mode: the next boot runs the Wi-Fi console once and then
// returns to Matter. RTC, because the request crosses an esp_restart().
RTC_NOINIT_ATTR static uint32_t rtc_matter_console;
#define MATTER_CONSOLE_MAGIC 0xC0501E5Au
// Set when a scheduled network window failed to connect. Only a FAILURE is worth showing: the
// radio is off almost all the time by design, so a permanent Wi-Fi icon would say nothing.
RTC_NOINIT_ATTR static bool     rtc_wifi_fail;
// How many consecutive joins have failed, and how many scheduled wakes to sit out before trying
// again. Counted in WAKES rather than seconds deliberately: this is the one path where the clock
// may never have been set at all, because NTP needs the very network that is refusing to answer.
RTC_NOINIT_ATTR static uint8_t  rtc_wifi_fails;
RTC_NOINIT_ATTR static uint16_t rtc_wifi_skip;
RTC_NOINIT_ATTR static float    rtc_pres_pa;       // last good pressure, for CO2 compensation
// Last readings, so a clock-only tick can redraw the screen without waking the sensors.
RTC_NOINIT_ATTR static uint16_t rtc_co2;
// Consecutive CO2 read failures. The screen has always had an "SCD41 is broken" state (4.14: hero
// "---", climate "--", an inverted "Error" in the air block, scale arrow hidden) and the renderer
// has always had the branches for it — but NOTHING in the firmware ever set the flag, so the
// branches were unreachable code. What the glass showed instead of that state was a hero reading
// "---" beside a confident computed verdict, the last good temperature and humidity presented as
// current, and the scale arrow parked in the white "good" third of the pill (atoi("---") is 0,
// clamped up to 400). Every one of those is a wrong statement, and this unit's SCD41 has in fact
// failed once (4.23). Three misses in a row is a fault, not a hiccup; one is not worth alarming
// over, and the freshness tag already ages visibly meanwhile.
RTC_NOINIT_ATTR static uint8_t rtc_co2_fails;
RTC_NOINIT_ATTR static float    rtc_temp, rtc_hum, rtc_iaq, rtc_soc;
// What the gauge said, before the charging cap adjusted it for a human to read (battery_monitor.h).
// The history ring logs this one: it is a measurement record and the raw material for working out
// this cell's discharge curve, and the curve is what plate v2 will need once the gauge is gone.
RTC_NOINIT_ATTR static float    rtc_soc_raw;
RTC_NOINIT_ATTR static uint8_t  rtc_acc;
// The web console asks for a good deal more than the glass shows, and it can be opened on a
// clock-only tick when no sensor ran. So everything it reports is cached here too, and republished
// on every wake — otherwise the dashboard shows zeros for the four minutes between measurements.
RTC_NOINIT_ATTR static float    rtc_volt, rtc_crate;              // battery: cell voltage, %/h
// Which way this board reads its cell, remembered from the last measurement tick so the screen can
// answer without bringing the I2C bus up. Garbage out of an uninitialised RTC cannot mislead here:
// the reader tests against the two named values and treats anything else as "not known yet".
RTC_NOINIT_ATTR static uint8_t  rtc_bat_rev;
// The cable as the battery monitor last saw it (0/1; anything else — garbage after a new image — just
// means "read it again"). See follow_cable().
RTC_NOINIT_ATTR static uint8_t  rtc_bat_cable;

// Is the charge finished? ONE rule, in one place.
//
// It used to be written out twice, character for character, in the Telegram reply and on the
// screen. Two copies of one rule are one edit away from telling the owner two different things,
// and this one was about to be edited: v2 answers it from hardware.
static bool charge_finished(bool usb)
{
    if (!usb) return false;
    // v2: the charger itself, through STDBY#. Readable from a GPIO alone, which is what makes it
    // usable here — this runs while drawing, long after the I2C bus went down.
    if (rtc_bat_rev == BatterySource::RevDividerV2) return BatterySource::chargeComplete(true) == 1;
    // v1, and the fallback before the first measurement tick of a new image: inferred, because a
    // gauge is all that board has. Near-full voltage with a rate too slow to be charging is
    // TP4056's termination window. On a v2 board this can call a finished charge "still charging"
    // for one frame, and the next measurement tick corrects it.
    return rtc_volt >= 4.10f && fabsf(rtc_crate) < 0.5f;
}

// The battery as the dashboard shows it — the figure and the bolt — in one place, so the QR screen a
// long press brings up without a network says exactly what the dashboard said a minute ago. The
// charger's verdict outranks the estimate; a bolt means current is flowing (see draw_dashboard()).
static PortalScreen::Battery shown_battery(bool usb, bool charge_done)
{
    PortalScreen::Battery b;
    b.usb = usb;
    // -1 = the cell has not been read; the charger's own verdict outranks the estimate.
    b.percent = charge_done ? 100 : (rtc_soc > 0.0f ? (int)rtc_soc : -1);
    b.charging = usb && !charge_done && rtc_soc > 0.0f;
    return b;
}
RTC_NOINIT_ATTR static float    rtc_bat_ttf;
RTC_NOINIT_ATTR static uint32_t rtc_bat_cycles;
RTC_NOINIT_ATTR static int      rtc_bat_state;
RTC_NOINIT_ATTR static uint8_t  rtc_bat_alerts;
RTC_NOINIT_ATTR static float    rtc_b_temp, rtc_b_hum;            // gas sensor's own climate
RTC_NOINIT_ATTR static float    rtc_gas_ohm, rtc_siaq, rtc_gasp;  // raw gas, static IAQ, gas %
RTC_NOINIT_ATTR static float    rtc_stab, rtc_runin;              // BSEC stabilisation / run-in
// Low-battery lockout. Latched, because the threshold must not be crossed back and forth: a cell
// that has just been rescued from 3.30 V will read higher the moment the load drops, and without
// hysteresis the device would wake, measure, lock, wake again, all the way down.
// Severity of the current air verdict, kept so the cycle can decide whether it is worth waking the
// radio for. The classifier itself runs every measurement regardless — the screen must always tell
// the truth; this is only about whether anyone gets told.
// Outcome of the LAST CO2 attempt, kept across sleeps. A measurement happens every few minutes at
// most and the USB port barely exists during those windows, so the evidence has to survive until
// a tick that can actually be read.
// When the gas calibration was last written to flash, and at what accuracy. RTC alone is not
// enough for it: it survives sleep and restarts but not the power actually going away, and the
// calibration it holds takes HOURS to rebuild from nothing.
RTC_NOINIT_ATTR static time_t   rtc_bsec_nvs_at;
RTC_NOINIT_ATTR static uint8_t  rtc_bsec_nvs_acc;
RTC_NOINIT_ATTR static float    rtc_toff_applied;   // offset last written to the sensor
RTC_NOINIT_ATTR static char     rtc_co2_diag[64];
RTC_NOINIT_ATTR static uint8_t  rtc_alert_tier;
RTC_NOINIT_ATTR static bool     rtc_lockout;
RTC_NOINIT_ATTR static bool     rtc_lock_drawn;
RTC_NOINIT_ATTR static int8_t   rtc_pres_mode;  // barometric forecast, recomputed each measurement
RTC_NOINIT_ATTR static uint8_t  rtc_pres_miss;  // gas samples in a row without a pressure in range
RTC_NOINIT_ATTR static int8_t   rtc_ptrend;
RTC_NOINIT_ATTR static int      rtc_class;                        // air classifier verdict
// The same cascade without moisture. The Air Quality block shows THIS, so that a damp room no
// longer hides the gas word behind «Damp»; rtc_class keeps damp and keeps driving the alerts.
RTC_NOINIT_ATTR static int      rtc_air_class;
RTC_NOINIT_ATTR static char     rtc_cls_txt[40];
RTC_NOINIT_ATTR static AlertState rtc_alert;                      // hysteresis across sleeps
// The debounced class the device is willing to stand behind. It differs from rtc_alert.notified_class
// exactly while a message is owed, which is the whole definition of "something to send".
RTC_NOINIT_ATTR static int      rtc_alert_confirmed;
// The reading that TRIPPED the alert. A message must describe the event it reports, not the moment
// it happened to be delivered — the text said exactly that in a comment and then quoted the live
// value anyway, producing "936 ppm, above the 1100 you set": a sentence that contradicts itself and
// teaches the owner the device does not mean what it says. CO2 beside a person falls fast, so by
// the time a radio window opens the number has always moved on.
RTC_NOINIT_ATTR static uint16_t rtc_alert_co2;
RTC_NOINIT_ATTR static float    rtc_alert_iaq;   // the index that tripped a gas alert, for the same reason
RTC_NOINIT_ATTR static time_t   rtc_alert_at;    // when the reading behind the pending message was taken
// Everything the pending message quotes, frozen with rtc_alert_at at the reading that decided it. The message
// can leave a window or two later, and the numbers it prints must belong to the time it prints.
RTC_NOINIT_ATTR static uint16_t rtc_msg_co2;
RTC_NOINIT_ATTR static float    rtc_msg_iaq, rtc_msg_temp, rtc_msg_hum;
// Frozen with the rest of them: the surface humidity the damp verdict was taken on, and the
// outdoor temperature it was worked out from. A message that quoted today's weather for an alert
// raised this morning would be telling the owner about a wall that no longer exists.
RTC_NOINIT_ATTR static float    rtc_msg_srh, rtc_msg_out;
RTC_NOINIT_ATTR static uint8_t  rtc_msg_acc;
// Did the last attempt to reach the weather service fail? Separate from "is there a cached
// city", which is what wx_state used to be derived from and which stays true for ever.
RTC_NOINIT_ATTR static bool     rtc_wx_failed;
// How many wakes have happened with no valid wall clock. The bootstrap that measures on every
// wake has to be bounded by something, and with no clock it cannot be bounded by time.
RTC_NOINIT_ATTR static uint32_t rtc_blind_wakes;
// Boots that never reached sleep. Incremented before anything can fail and cleared at the one
// moment that proves a boot did its job — arriving at esp_deep_sleep_start(). A device that panics
// early otherwise reboots for ever: this is the only state in which the firmware cannot report its
// own failure, because nothing it writes afterwards ever runs.
//
// In RTC and not NVS on purpose: this is touched twice per wake, about 2900 times a day, and NVS
// has a finite number of writes. The guard is folded with buildStamp() so a new image starts its
// own count — a fresh binary must not inherit the previous one's failures — and so that garbage
// read through a moved RTC layout cannot present itself as "five failures already".
RTC_NOINIT_ATTR static uint32_t rtc_boot_guard;
RTC_NOINIT_ATTR static uint8_t  rtc_boot_incomplete;
RTC_NOINIT_ATTR uint8_t rtc_sec_updated;   // an update was committed; tell the owner once
// RTC, not .bss. The comment above promises "otherwise at the next radio window", and between the
// console window and that next window the device deep sleeps — which wipes .bss. So the fallback
// path this queue was written for could never once have run: a notice not delivered inside the
// window died at the next sleep, silently, and the three retries were unreachable. Reviewed
// 2026-09-18. Cleared in forget_previous_build(), which is also what makes power-on garbage safe.
RTC_NOINIT_ATTR static char    s_sec_note[192];   // the longest of these texts, plus a version string
RTC_NOINIT_ATTR static uint8_t s_sec_tries;
#define BOOT_FAIL_REVERT   5    // enough to be a pattern, few enough to cost seconds
#define BOOT_FAIL_BARE     8    // safe mode itself is not completing: stop raising the radio too

RTC_NOINIT_ATTR static char     rtc_wx_city[24], rtc_wx_desc[26], rtc_wx_icon[6];
RTC_NOINIT_ATTR static float    rtc_wx_temp, rtc_wx_feels, rtc_wx_wind, rtc_wx_lo, rtc_wx_hi;
// Today's low and high, accumulated WIDEN-ONLY. An extreme once seen is kept for the rest of the
// day and never recomputed away: the morning's low is only ever a FUTURE forecast entry for a few
// hours, and recomputing from a fresh forecast later would throw it away and report the remaining
// day's low instead (CLAUDE.md 4.14). Reset happens at local midnight, nowhere else.
RTC_NOINIT_ATTR static float    rtc_day_lo, rtc_day_hi;
RTC_NOINIT_ATTR static int32_t  rtc_day_stamp;      // local day number the pair belongs to
RTC_NOINIT_ATTR static int      rtc_wx_hum;
// The extra cells of the configurable bottom strip. Sentinels rather than zeroes: 0 % cloud and
// 0 % cloud is a real reading, "never fetched" is not, and the strip must be able to
// tell them apart to print dashes.
RTC_NOINIT_ATTR static float    rtc_wx_uv, rtc_wx_dew;
RTC_NOINIT_ATTR static int      rtc_wx_cloud;
// The four-day outlook, one entry per local calendar day. Kept by DATE, not by position: an outlook
// that missed its refresh across a midnight would otherwise show yesterday's "tomorrow" as tomorrow.
// The row matches days to today's date when it is drawn, and a day it has nothing for reads "--".
// Not mirrored to flash like today's min/max: every day of it is still in the future, so the next
// weather window simply fetches it again.
RTC_NOINIT_ATTR static WxDay    rtc_fc[4];

// Days since 1 January 1970 for a calendar date (proleptic Gregorian) — Howard Hinnant's
// days_from_civil. Exact for any date this device will see, no tables and no time zone involved,
// which is the point: a date string from the hub is already a local date.
// --- Reducing the local reading to sea level --------------------------------------------------
//
// The barometric forecast needs the LEVEL as well as the rate (analytics.h), and a level only
// means anything reduced to sea level. The reduction is a multiplier set by altitude — and the
// device is not asked for its altitude, it MEASURES it: MET sends air_pressure_at_sea_level in
// the very response the forecast already costs, so the factor is that number divided by what this
// barometer reads at the same moment. No new request, no setting, nothing for the owner to get
// wrong.
//
// Checked against the geometry on 2026-10-05: this unit read 1005.9 hPa, MET said 1023.2, giving
// 1.0172, and the hypsometric value for its 146 m is 1.0174. Agreement to 0.2 hPa — and that is
// the accuracy the whole gate inherits, which is why the level hysteresis is a full hPa.
//
// In NVS, not RTC: it describes WHERE the device stands, and that outlives a reboot. Re-learned
// on every weather report and blended half and half after the first, so one odd grid value cannot
// drag it.
static constexpr float BARO_K_MIN = 1.00f;   // sea level
static constexpr float BARO_K_MAX = 1.45f;   // ~3000 m, past any room this device will stand in

// The textbook reduction, with the standard atmosphere's 15 C and 6.5 K/km lapse. The temperature
// barely matters here: across 0..25 C the factor for 146 m moves by 0.15 %, which is 0.03 hPa — so
// the air the column is actually at is not worth asking for.
static float baro_k_from_altitude(float metres) {
    const float lapse = 0.0065f * metres;
    return powf(1.0f - lapse / (15.0f + lapse + 273.15f), -5.257f);
}

// Where the factor came from, for the console: an owner told "no forecast" deserves to know
// whether the device never saw weather or never got a city.
enum BaroSrc : uint8_t { BARO_SRC_NONE = 0, BARO_SRC_MEASURED = 1, BARO_SRC_CITY = 2 };

static float baro_factor(uint8_t *src = nullptr) {
    if (src) *src = BARO_SRC_NONE;
    // Measured against a weather report: good to a couple of tenths of a hPa. Always wins.
    float k = 0.0f;
    if (NVSManager::getInstance().getFloat("baro_k", k, 0.0f) && k >= BARO_K_MIN && k <= BARO_K_MAX) {
        if (src) *src = BARO_SRC_MEASURED;
        return k;
    }
    // Fallback: the altitude of the chosen city, carried in by the console with its coordinates.
    // A city-centre average, so a few hPa out in hilly places — but the gate it feeds separates
    // high pressure from low, a step of some 15 hPa, and it is replaced by the measured factor the
    // moment any weather arrives. This is what keeps the plaque alive on a Matter unit, which goes
    // online once during setup and never again.
    float alt = 0.0f;
    if (NVSManager::getInstance().getFloat("wx_alt", alt, NAN) && isfinite(alt) &&
        alt > -500.0f && alt < 9000.0f) {
        const float ka = baro_k_from_altitude(alt);
        if (ka >= BARO_K_MIN && ka <= BARO_K_MAX) {
            if (src) *src = BARO_SRC_CITY;
            return ka;
        }
    }
    return NAN;
}

// Sea-level hPa, or NAN while the device has never seen a weather report — and then there is no
// forecast at all, only the number. Deliberate: a word we cannot stand behind is worse.
static float baro_sea_level(float local_hpa) {
    const float k = baro_factor();
    return isfinite(k) ? local_hpa * k : NAN;
}

static void baro_learn_factor(float p_sea_hpa) {
    if (!(p_sea_hpa > 800.0f && p_sea_hpa < 1100.0f)) return;           // MET sent nothing usable
    if (!(rtc_pres_pa > 30000.0f && rtc_pres_pa < 110000.0f)) return;   // our own barometer is out
    const float fresh = p_sea_hpa / (rtc_pres_pa / 100.0f);
    if (!(fresh >= BARO_K_MIN && fresh <= BARO_K_MAX)) {
        ESP_LOGW(TAG, "BARO: altitude factor %.4f out of range, ignored", fresh);
        return;
    }
    const float had = baro_factor();
    const float k = isfinite(had) ? (had + fresh) / 2.0f : fresh;
    if (isfinite(had) && fabsf(k - had) < 0.0005f) return;              // not worth a flash write
    if (NVSManager::getInstance().setFloat("baro_k", k))
        ESP_LOGI(TAG, "BARO: altitude factor %.4f (this report %.4f) -> sea level %.1f hPa",
                 k, fresh, rtc_pres_pa / 100.0f * k);
}

static int32_t days_from_civil(int y, unsigned m, unsigned d)
{
    y -= m <= 2;
    const int era = (y >= 0 ? y : y - 399) / 400;
    const unsigned yoe = (unsigned)(y - era * 400);
    const unsigned doy = (153 * (m > 2 ? m - 3 : m + 9) + 2) / 5 + d - 1;
    const unsigned doe = yoe * 365 + yoe / 4 - yoe / 100 + doy;
    return era * 146097 + (int32_t)doe - 719468;
}
// What is CURRENTLY on the glass. Cutting the panel's power in sleep wipes the controller's own
// copy of the previous frame, and a partial update only drives pixels that differ from it — with
// no reference the new digits are laid ON TOP of the old ones. So we re-render the previous frame
// from these values, hand it over as the baseline, and only then draw the new one.
// EVERY field that reaches the glass lives in here. A field read straight from a live variable
// would be re-rendered with its NEW value while replaying the OLD frame, so the baseline would
// not match the glass and the old text would survive as a ghost. The weather did exactly that
// once already (CLAUDE.md 4.14) — hence one struct, no exceptions.
struct Frame {
    char date[16], time[8], co2[8], temp[8], hum[8], pres[12], cal[8], aq[sizeof(rtc_cls_txt)];   // aq: the classifier's word
    bool aqInv;
    bool humDamp;     // the humidity block says «Damp» and inverts (owner, 2026-10-02)
    int8_t aqLevel;   // seven Bosch cells filled up to this class; -1 = none
    bool err;       // climate channel down: SCD41 gives CO2, temperature AND humidity
    // The offset the graph's own time labels were rendered with. The fourth violation of the 4.7
    // rule hid here, in the one field that looks safe because its DATA is in the frame: the
    // timestamps were, but the offset applied to them was read live from NVS, so the first partial
    // draw after a timezone change replayed yesterday's frame with today's offset, the baseline
    // disagreed with the glass, and the old hour digits were never cancelled.
    int16_t tzmin;
    // Header state. In the frame like everything else: the plug appears and disappears with the
    // cable, so read live it would ghost on the next partial update.
    bool night;     // moon in place of the clock: no minute ticks to keep it honest
    bool usb;       // plug icon: on the wire
    bool chg;       // lightning on the battery: actually taking charge
    bool lowbat;    // inverted % pill
    bool wifiFail;  // "!wifi" pill after a sync that did not succeed
    int  batt, outT;
    char city[24], desc[26], icon[8], lo[8], hi[8], ohum[8], wind[8], feels[8];
    // The configurable bottom strip, already formatted. Which three cells are shown is the owner's
    // choice, so `strip` belongs here too: change it in the console and the frame must differ, or
    // the "nothing changed" check would keep the old strip on the glass.
    uint32_t strip;
    char uv[8], sunrise[8], sunset[8];
    // The phase QUANTISED to 48 steps, not the raw fraction: the real phase changes every second,
    // and a frame that never equals the last one would repaint the panel every single minute.
    // Forty-eight steps is one every fifteen hours, which over-samples the ten pictures a 9 px disc
    // can actually show. -1 = no clock, so no phase.
    int8_t moonQ;
    // The outlook row, exactly as drawn: the weekday word, the icon code and both temperatures
    // already in the owner's unit. The weekday is here too, not recomputed while replaying the
    // previous frame — at midnight every name shifts by one, and a replay with the NEW names
    // would leave the old ones on the glass. fc_n 0 = no row.
    int8_t   fc_n;
    char     fc_day[4][8], fc_icon[4][4], fc_hi[4][6], fc_lo[4][6];   // "Sat 12", "10d", "22", "-3"
    // The console's address band. It MUST live in the frame like everything else: it was read from
    // a live argument instead, so once the console closed the previous frame was replayed without
    // the band that was still on the glass — and the band never came off. The graph broke with it,
    // because the band shortens the graph: the replay drew a different-length line, which then
    // could not cancel the one on the glass, and they stacked.
    char     presU[6];         // "hPa" or "mmHg", per the user's setting
    bool     updClock;         // show the last reading's time, prefixed, instead of a live clock
    int8_t   noNet;            // 0 = normal, 2 = offline layout: full-width graph, no outdoor block
    int8_t   presMode;         // 0 number, 1 Rain, 2 Storm (inverted)
    int8_t   ptrend;           // pressure trend arrow: -1 down, 0 flat, +1 up
    char     fresh[8];         // age of the CO2 reading:  "now" / "12m" / "3h" / "2d"
    char     wxFresh[8];       // age of the outdoor weather
    char     setup[40];
    char     setup2[40];   // second row of the band: the console password
    uint16_t g_co2[48];        // graph samples, oldest -> newest
    uint8_t  g_n;
    uint32_t g_t0, g_t1;       // the span the samples actually cover, for the axis labels
};
RTC_NOINIT_ATTR static Frame rtc_prev;
// RTC memory survives a reflash, so after a rebuild that changed the layout above, the "previous
// frame" is the old bytes read through the new struct — nonsense presented as what is on the
// glass, which a partial update would then paint over. A build stamp catches it: when it changes,
// the frame is disowned and the next draw is a full refresh, which needs no reference at all.
// Identifies THIS binary, and it has to identify the binary rather than the moment it was built.
// It was hashed from __DATE__ __TIME__, which made it the single reason the same source could never
// produce the same image twice — and a firmware nobody can reproduce is a firmware nobody can check
// against the repository, which is the first question asked after a bad update and the only one an
// update channel makes urgent.
//
// The ELF hash says the same thing more honestly: identical source gives an identical stamp, so a
// rebuild that changed nothing no longer throws away the RTC state, and any real change still
// invalidates it. IDF computes and embeds this already; nothing is added to the image for it.
static uint32_t buildStamp() {
    const esp_app_desc_t *d = esp_app_get_description();
    uint32_t h = 2166136261u;
    if (d) for (size_t i = 0; i < sizeof(d->app_elf_sha256); i++)
        h = (h ^ (uint32_t)d->app_elf_sha256[i]) * 16777619u;
    return h ? h : 1u;      // zero is the one value RTC garbage is most likely to hold
}
RTC_NOINIT_ATTR static uint32_t rtc_build_stamp;

// The detail word of a boot record. Low byte is the reset reason, bit 8 says the boot never
// reached sleep, bit 9 says this is the first wake of a new image, and the top half carries the
// image's own fingerprint. Packed rather than split across fields because `detail` is the one
// free word in a 32-byte record, and the reader already masks the low byte, so old tools keep
// working against new records.
static inline uint32_t boot_detail(esp_reset_reason_t r, uint32_t bits)
{
    return ((uint32_t)r & 0xFFu) | bits | ((buildStamp() & 0xFFFFu) << 16);
}

// Bumped by the web server on every request — the setup window uses it as "the user is still
// working", so the countdown restarts instead of expiring under their hands.
extern uint32_t global_last_http_ms;
extern int      global_portal_remain;   // seconds left, published to the console UI
extern volatile bool global_screen_dirty;
extern volatile bool global_weather_dirty;
extern volatile bool global_hub_dirty;
extern volatile bool global_portal_close;
extern volatile bool global_factory_req;   // the console asked for a factory reset
extern volatile bool global_reboot_req;    // the console asked for a restart
extern volatile bool global_close_req;     // the console asked to end the session now
extern volatile bool global_poweroff_req;  // ...or for the device to be switched off
extern volatile uint32_t global_temp_seq;  // readings taken with the temperature offset on file
extern volatile int global_calib_req;         // ppm the page wants to calibrate to (0 = idle)
extern volatile int global_calib_result;     // 2 running / 3 asking / 1 done / -1 failed / 0 idle
extern volatile int global_calib_correction;
extern volatile int global_calib_samples;    // run-up readings taken since the request
extern volatile int global_calib_error;      // 1 window closed, 2 sensor refused, 3 no sensor,
                                             // 4 not outdoor air and nobody said to go on
extern volatile int global_calib_lo;         // what the run-up read: lowest, highest, mean (ppm)
extern volatile int global_calib_hi;
extern volatile int global_calib_avg;
extern volatile int global_calib_confirm;
extern volatile int global_calib_unsettled;
extern volatile int global_calib_settled;    // the page's answer while asking: 1 go on, -1 stop
extern volatile int global_wifi_connect_req;    // set by /api/save when credentials are stored
extern volatile int global_wifi_connect_state;
// Telemetry the web console reads through /api/status. It is served straight out of these, so
// nothing appears in the dashboard until the cycle publishes into them.
extern float global_voltage, global_soc, global_soc_raw, global_crate;
extern uint32_t global_btn_noise;
extern uint16_t global_co2;
extern float global_s_temp, global_s_hum, global_b_temp, global_b_hum, global_b_pres, global_b_gas;
extern float global_iaq, global_static_iaq, global_gas_percentage, global_dewpoint;
extern uint8_t global_iaq_accuracy;
extern float global_stab_status, global_run_in_status;
extern int global_pollution_class;
extern std::string global_pollution_text;
extern uint32_t global_boot_count;
extern int   global_bat_state;
extern float global_bat_ttf_h;
extern uint32_t global_battery_cycles;
extern uint8_t  global_bat_alerts;
extern bool  global_bat_low, global_on_usb;
extern float global_out_temp, global_out_uv, global_out_dew;
extern float global_surface_rh;
extern float global_p_sea; extern float global_baro_k; extern uint8_t global_baro_src;
extern int global_out_cloud;
extern std::string global_out_desc, global_out_city, global_out_icon, global_wx_state;

// What the cycle decided on this wake. Published so the Mode tab can show the schedule in force
// rather than the one on file — they differ at night, in Ultra Save, and before the first sync.
int    global_plan_profile   = 1;
bool   global_plan_night     = false;
uint32_t global_plan_meas_min  = 5;
uint32_t global_plan_radio_min = 30;
bool   global_plan_live_clock  = true;
uint32_t global_plan_last_meas = 0;   // unix seconds; 0 = nothing measured yet
uint32_t global_plan_last_co2  = 0;


extern bool     global_portal_keep;   // user tapped the timer pill: stretch the window  // 0 idle, 1 connecting, 2 joined, -1 failed

RTC_NOINIT_ATTR static bool     rtc_prev_valid;
// How many wakes in a row the USB pin has raised without the cable state actually having changed.
// The flight recorder's first run found the reason this has to be counted: with the cable OUT, the
// detect line still produced 45 state changes in eight minutes, the device woke on every edge —
// 207 wakes where 8 were due — and since the plug icon follows the cable, the panel was partially
// refreshed once every four seconds. That is 44x the interval the panel vendor asks for, with 111
// partials in a row and a single cleaning frame.
RTC_NOINIT_ATTR static uint8_t  rtc_usb_spurious;
// How long a wake takes from the timer firing to the pixels being settled. Measured, not assumed,
// and kept separately per kind of tick because they differ by an order of magnitude: a clock-only
// tick is around a second, a measuring one around six. Waking this much EARLY is what puts the new
// minute on the glass at the minute, instead of a second and a half after it.
// Is the panel currently powered? A wake that draws nothing must leave the switch exactly as the
// last one set it, so the state has to outlive the sleep.
RTC_NOINIT_ATTR static bool rtc_panel_powered;
// Consecutive button wakes with nothing pressed. Feeds the back-off in arm_wake_pins().
RTC_NOINIT_ATTR static uint32_t rtc_btn_ghosts;
// Setup windows in a row that a finger-less button wake opened and nobody used. See the classifier.
RTC_NOINIT_ATTR static uint8_t  rtc_portal_unused;
#define PORTAL_UNUSED_MAX 3
// A factory reset that was asked for and not yet carried out. Mirrored in NVS as "fr_pending":
// this copy does not survive the power going away, and the NVS one does.
RTC_NOINIT_ATTR static uint32_t rtc_factory_req;
#define FACTORY_REQ_MAGIC 0xFAC70E5Eu
// Is the logo already the picture on the glass? Redrawing it costs ten seconds of a 4-gray
// refresh and changes nothing a person could see.
RTC_NOINIT_ATTR static bool rtc_logo_shown;
RTC_NOINIT_ATTR static bool rtc_ink_blocked;   // updates paused: the room is outside the panel's range
RTC_NOINIT_ATTR static uint8_t rtc_bat_notified;
// The last thing worth telling the owner, composed ONCE and then handed to whoever can deliver it.
//
// Both channels used to decide for themselves what counted as an event: the device notified from
// a gas calibration of 1 of 3, the hub rule demanded 3 of 3, and the two quietly disagreed about
// the same air. Two opinions is one too many. Now the device decides and writes the finished words
// here; Telegram sends them, the state message carries them, and neither is allowed a view.
RTC_NOINIT_ATTR static char rtc_al_title[56];
RTC_NOINIT_ATTR static char rtc_al_text[640];
RTC_NOINIT_ATTR static char rtc_al_level[10];   // clear | info | advisory | warning | critical
// Deliveries still owed for the text above. Telegram used to be sent whenever that text merely
// EXISTED — and it exists for good, because it lives in RTC memory. So every radio window, and
// every long press that opened the console, re-sent whatever was last said. This counts down
// instead: an event is delivered once, with a couple of retries in later windows if the send
// itself fails, and then never again.
RTC_NOINIT_ATTR static uint8_t rtc_al_tries;
// The hub is also told about each new event on its own, as a message on <topic>/alert (2026-09-22).
// The state message carries the alert too, but repeats it every window for as long as it stands, so
// a hub forwarding it to a phone has to watch one sensor for a CHANGE — and that sensor's name comes
// from whatever the owner called the device. An event needs nothing of the sort: one subscription,
// any hub, any name. rtc_al_seq counts events; rtc_al_hub is the last one the broker acknowledged.
// Unequal means one is owed, and it is retried in the next window until it is taken.
RTC_NOINIT_ATTR static uint32_t rtc_al_seq, rtc_al_hub;
RTC_NOINIT_ATTR static time_t rtc_mqtt_disco_at;   // when Home Assistant was last told what this device is  // low-battery levels already announced: 1=15% 2=10% 4=5%
RTC_NOINIT_ATTR static bool rtc_was_night;     // to catch the moment night ends
RTC_NOINIT_ATTR static uint32_t rtc_lat_clock_ms;
RTC_NOINIT_ATTR static uint32_t rtc_lat_meas_ms;
// Everything between the timer firing and app_main existing — ROM loader, flash init — happens
// before esp_timer exists and cannot be measured from inside. Rather than model it, the residual
// error is fed back: half of it each tick, clamped, until it settles.
RTC_NOINIT_ATTR static int32_t  rtc_sync_trim_ms;
RTC_NOINIT_ATTR static time_t   rtc_last_full;      // when the panel was last fully refreshed
RTC_NOINIT_ATTR static uint32_t rtc_partials;      // partial updates drawn since then

// The LED is the only feedback available once the cable is off. It is held STEADY for as long as
// the device is busy with something the user asked for, and is dark the rest of the time — a
// scheduled wake never lights it. Blink sequences were tried and removed: several flashes a second
// read as a fault indicator, not as an acknowledgement.

// A plain level on a pad. It used to need a no-light-sleep lock: on battery every vTaskDelay let the
// chip doze, the doze isolated this pad, and the light strobed while the device polled the button.
// Light sleep is gone from the firmware (power-management block in bench_screens_run()), so a level
// set here stays set.
static void led(bool on)
{
    gpio_set_level(PIN_LED, on ? 1 : 0);
}

// A press that arrives while the device is busy used to vanish.
//
// The button is only ever read as a reason for waking; between waking and going back to sleep —
// about a second on a clock tick, six on a measurement, twenty in a radio window — nothing looks
// at it. That is three to five per cent of the time, which matches exactly what was reported: it
// works, and occasionally the first press does nothing at all and the second one is fine.
//
// An interrupt costs nothing while idle and catches the press. It cannot be acted on immediately —
// the device is in the middle of a measurement or a network session, and interrupting those would
// trade one lost press for corrupted readings — so it is remembered and honoured at the end of the
// cycle, by waking straight back up and running the tick as if the button had woken it.
static volatile bool s_btn_pressed_while_awake = false;
RTC_NOINIT_ATTR static bool rtc_btn_pending;   // survives the moment of sleep, read on the way back

// What the air did while everyone was asleep.
//
// The radio is off all night in every profile, so a hub sees an eight-hour hole and can say
// nothing about the one stretch a bedroom monitor exists for. Past readings cannot be filled in
// afterwards — Home Assistant timestamps a state when it arrives, not when it was measured, and no
// standard offers a way round that. What CAN be carried across the gap is the shape of the night,
// computed here from the log the device kept anyway and published once in the morning.
RTC_NOINIT_ATTR static uint16_t rtc_ns_co2_max, rtc_ns_co2_avg;
RTC_NOINIT_ATTR static float    rtc_ns_t_min, rtc_ns_t_max, rtc_ns_h_max;
RTC_NOINIT_ATTR static uint32_t rtc_ns_from, rtc_ns_to;   // 0 = nothing to report
// When the night actually began. The summary used to look back a flat twelve hours, so with the
// default window of 23:00-07:00 it reported five hours of the evening as part of the night —
// including the CO2 peak of a room full of awake people, presented to the hub as what happened
// while everyone slept.
RTC_NOINIT_ATTR static uint32_t rtc_night_began;

// Rejected edges survive the sleep, because the question is not "was there noise in this one
// second of awake time" but "is this device being falsely woken over days". It is published with
// the readings for the same reason: during a battery run the serial port does not exist, and a
// counter that can only be read over USB is a counter that cannot be read when it matters.
RTC_NOINIT_ATTR static uint32_t rtc_btn_noise;

// Edges that were not a press. A real press pulls the line to ground and HOLDS it there for tens
// of milliseconds; a coupling spike is over before the handler has finished reading the register.
static volatile uint32_t s_btn_glitches = 0;

// When the finger went down, by the monotonic clock of THIS boot. Only the first edge of a press
// sets it; the bounce that follows must not restart the clock it is meant to measure.
static volatile int64_t s_btn_press_us = 0;
// A press that began BEFORE this boot, in milliseconds already served. See the classification loop.
RTC_NOINIT_ATTR static uint32_t rtc_btn_held_ms;

static void IRAM_ATTR btn_isr(void *)
{
    // This accepted ANY falling edge, and the consequence was not a stray flag: a press caught here
    // makes the device wake back up in 50 ms and treat the next tick as a button press, which turns
    // on the light, forces a full refresh and forces the radio up. So one microsecond of noise on
    // this pin bought a flashing screen at night, a lit LED and a Wi-Fi session — observed on the
    // battery run, in night mode, with nobody near the device.
    //
    // The suspect is the panel's power FET, switched at the end of every cycle a few millimetres
    // away; this handler is armed across exactly that moment. Rather than trust that identification,
    // reject what cannot be a press and count what was rejected, so the noise becomes a number in
    // the log instead of a theory.
    if (gpio_get_level(PIN_USER_BTN) != 0) { s_btn_glitches = s_btn_glitches + 1; rtc_btn_noise++; return; }
    if (!s_btn_pressed_while_awake) s_btn_press_us = esp_timer_get_time();   // first edge only
    s_btn_pressed_while_awake = true;
}

// The same thing as the low branch above, but reachable from a task. PmGate calls it when one of
// the sensor waits ends with the button held down: inside that wait the chip may have been in light
// sleep and the pin's interrupt is off anyway, so the press left no edge for btn_isr to see. Only
// the line itself is left as evidence, and it is read the same way here.
static void note_button_from_nap(void)
{
    if (!s_btn_pressed_while_awake) s_btn_press_us = esp_timer_get_time();
    s_btn_pressed_while_awake = true;
}

// Evidence that the light-sleep gate did something, written where it can still be read a week
// later from a battery run. Self-limiting on purpose: the first 64 measuring wakes of an image,
// about five hours, and then silence — enough to answer "did it work", cheap against a ring of
// 8192 slots, and it re-arms itself on the next image, which is exactly when the question returns.
static void note_light_sleep(void)
{
    // RTC_NOINIT is uninitialised memory, and the counter only ever reaches 64 by its own early
    // return below — so anything past that is the garbage a fresh layout left behind, not a count.
    // This is not a hypothetical: the first version reset it in forget_rtc_state() instead of
    // forget_previous_build(), the garbage read as a huge number, and the feature wrote nothing at
    // all after a flash while looking perfectly healthy.
    if (rtc_ls_notes > 64) rtc_ls_notes = 0;
    if (rtc_ls_notes >= 64) return;
    rtc_ls_notes++;
    uint32_t ms = (uint32_t)(PmGate::slept_us() / 1000);
    uint32_t n  = PmGate::sleeps();
    if (ms > 16383) ms = 16383;
    if (n  > 1023)  n  = 1023;
    EvtLog::getInstance().event(EVT_NOTE, (uint32_t)NOTE_LIGHT_SLEEP | (ms << 8) | (n << 22));
}

// Wait for the finger to come off, but never forever. A press is only finished when the button is
// released, so the code that follows has to wait for it — and an unconditional wait hands the
// device to whatever is holding the button down. A jammed button, or a person who holds it because
// nothing seems to be happening, would starve the watchdog: it panics at a minute, the device
// reboots, wakes on a button that is still down, and does it again — a reset loop that flattens the
// cell instead of showing anything. So it gives up after ten seconds and carries on; a press that
// long was not a press.
// Brings the gas calibration back from flash: the state's clock, the gap since the snapshot, and
// the room's own norm. Two different events need exactly this — a firmware change, which moves
// every RTC variable, and a power loss, which erases them — and they had drifted apart, with the
// power-loss path restoring only the clock and neither the gap nor the norm. One function, so the
// branch a customer's first update takes is the same one every reflash and every dead battery
// exercises here. Must run BEFORE anything initialises BSEC.
static void restore_gas_from_flash(const char *why)
{
    NVSManager::getInstance().init();
    BSECManager::invalidateRtcState();     // flash is the only source now, not a gamble on garbage
    // Arm the gate probe: THIS boot's load is the one worth recording, and nothing after it is.
    BSECManager::getInstance().armLoadProbe();

    uint32_t saved_clk = 0, saved_wall = 0;
    NVSManager::getInstance().getU32("bsec_clk",  saved_clk, 0);
    NVSManager::getInstance().getU32("bsec_wall", saved_wall, 0);
    const time_t now_w = time(NULL);
    int64_t gap = 0;
    if (saved_wall && now_w > 1600000000 && now_w > (time_t)saved_wall) {
        gap = (int64_t)(now_w - (time_t)saved_wall);
        // The ceiling the running clock already uses for a sleep gap. A compressed timeline is
        // survivable; an unbounded one is how a wrong wall clock becomes a gas timeline decades
        // long, and the algorithm answers that by discarding everything.
        if (gap > 3600) gap = 3600;
    }
    // Two seconds on top: the snapshot keeps whole seconds of a clock that had moved on by a fraction,
    // and BSEC takes only increasing timestamps (AN011, bsec_input_t::time_stamp).
    rtc_bsec_ns = ((int64_t)saved_clk + gap + 2) * 1000000000LL;
    {
        // The wall-clock moment this base belongs to; read_sensors() moves the base on from here.
        struct timeval tv; gettimeofday(&tv, NULL);
        rtc_bsec_wall_us = (tv.tv_sec > 1600000000) ? (int64_t)tv.tv_sec * 1000000LL + tv.tv_usec : 0;
    }

    ESP_LOGW(TAG, "%s — gas hand-off: clock %u s +%d s gap", why, (unsigned)saved_clk, (int)gap);
}

// The single fact this whole mechanism rests on: we got all the way to sleep, so this image can
// complete a cycle. Called at every sleep site — there are three, and a boot that reaches any of
// them has done its job.
// Arming the pins that can end a sleep, in one place for all four sleep paths.
//
// The USB choices are deliberately different and not an oversight. The working cycle wants to know
// about ANY change, so it arms for the opposite of the level it is sleeping at. Lockout and safe
// mode only care that a charger has arrived: they are already stopped, and being woken because the
// cable was removed would achieve nothing.
static bool usb_present(void);      // defined below

enum class UsbWake { None, OnPlug, OnChange };

// After this many pin wakes that changed nothing, stop arming the pin until a scheduled wake
// clears the count. Nothing is lost but the instant plug icon during a storm — the timer still
// brings the device up within its normal interval, and it notices the cable then.
static constexpr uint8_t USB_STORM = 8;

// Returns whether the button ended up armed. A caller whose sleep has no timer must look at this:
// if the button is not armed and no timer is set, the device never comes back.
static bool arm_wake_pins(UsbWake usb)
{
    // Espressif's sequence, from "Sleep Modes" in the ESP-IDF docs and the ESP-IDF deep_sleep example
    // (examples/system/deep_sleep/main/gpio_wakeup.c): the pin is configured as an input with
    // gpio_config(), then esp_deep_sleep_enable_gpio_wakeup(). The same docs say wakeup sources are
    // not disabled after a wakeup and have to be disabled with esp_sleep_disable_wakeup_source(), so
    // every sleep starts from none and each caller enables exactly what it wants after this returns.
    //
    // Not doing that is how the logo sleep broke on battery (hardware, 2026-09-11): the power manager
    // had left the timer source enabled (esp_pm_configure with light sleep, pm_impl.c), the logo
    // sleep never set a timer of its own, and it woke almost at once, over and over.
    esp_sleep_disable_wakeup_source(ESP_SLEEP_WAKEUP_ALL);

    // Levels are read here, after gpio_config() and before any wake is enabled.
    const bool usb_now = (usb != UsbWake::None) && usb_present();   // usb_present() configures the pad
    gpio_config_t btn = {};
    btn.pin_bit_mask = 1ULL << PIN_USER_BTN;
    btn.mode = GPIO_MODE_INPUT;
    gpio_config(&btn);
    const bool btn_down = (gpio_get_level(PIN_USER_BTN) == 0);

    // Arming the level a pin is already at wakes the device the instant it sleeps, for ever. The
    // button has one resting level (R10 holds it high), so a line still low here is left unarmed and
    // the caller's timer brings the device back. The same for a line that keeps waking the device
    // with no press behind it (rtc_btn_ghosts, counted by the wake classifier).
    bool armed = false;
    if (rtc_btn_ghosts >= 8) {
        ESP_LOGW(TAG, "button line produced %u phantom wakes — not arming it this time",
                 (unsigned)rtc_btn_ghosts);
        rtc_btn_ghosts = 0;                 // one clean attempt after the timer brings us back
    } else if (btn_down) {
        ESP_LOGW(TAG, "button still held at sleep entry — not arming it (would wake instantly)");
    } else {
        const esp_err_t be = esp_deep_sleep_enable_gpio_wakeup(1ULL << PIN_USER_BTN,
                                                               ESP_GPIO_WAKEUP_GPIO_LOW);
        if (be != ESP_OK) ESP_LOGE(TAG, "button wake arming FAILED: %s", esp_err_to_name(be));
        else              armed = true;
    }

    if (usb == UsbWake::None) return armed;
    // OnPlug waits for the cable to go in; OnChange waits for the level opposite to the current one.
    esp_deep_sleep_enable_gpio_wakeup(1ULL << PIN_USB_DETECT,
                                      (usb == UsbWake::OnChange && usb_now) ? ESP_GPIO_WAKEUP_GPIO_HIGH
                                                                             : ESP_GPIO_WAKEUP_GPIO_LOW);
    if (usb == UsbWake::OnChange)
        ESP_LOGW(TAG, "cable %s — will wake when it is %s",
                 usb_now ? "in" : "out", usb_now ? "pulled" : "plugged in");
    return armed;
}

static void settle_pending_image(void);
static void evt_log_wake(void);   // defined below, where this wake's own numbers are in scope

// Reaching sleep is the whole definition of a boot that worked, so both things that care about it
// hang here: the failed-boot counter resets, and a freshly installed image commits or reverts.
// settle_pending_image() used to sit at one call site out of the four below, which meant an update
// whose first wake took any other path — lockout, safe mode, the logo, the setup portal — stayed
// PENDING_VERIFY and would have reverted later at some unrelated brownout, long after anyone could
// connect the two events.
static inline void boot_reached_sleep(void)
{
    settle_pending_image();
    // The wake summary goes in AFTER settle_pending_image() deliberately: if that decides to
    // revert, the record of the wake that made the decision is already the last thing written, so
    // the log explains the rollback instead of stopping just before it.
    evt_log_wake();
    rtc_boot_incomplete = 0;
}

// What this wake learned about itself. Collected as the cycle runs rather than by a separate test
// afterwards, because the honest question for a new image is not "can it pass a checklist" but
// "did it just do its job" — and the cycle is the job. Nothing here costs anything: they are
// outcomes the code already had and threw away.
static int8_t   s_sensors_ok  = -1;     // of three on the bus, how many answered; -1 = not asked
static int64_t  s_draw_ms     = -1;     // last panel refresh, or -1 if none happened
static bool     s_served_page = false;  // this wake held a console or setup window open

// One record per wake, written from boot_reached_sleep(). Everything in it was gathered as the
// cycle ran, so this costs a single 32-byte page program — well under a millisecond.
static void evt_log_wake(void)
{
    // The wake record's free field carries the rejected-edge counter. It reached 23688 over a
    // 16-day run — about one per wake, which is far too regular to be stray pickup and points at
    // something the device itself does on the way in or out. A cumulative number cannot answer
    // that; per-wake values can, because they say WHICH wakes collect edges.
    EvtLog::getInstance().setDetail(rtc_btn_noise);
    EvtLog::getInstance().wake(0);
}

// Ten seconds, counted from the press itself and not from the end of the three-second signal.
// Far from the long-press threshold on purpose: by then the owner has already been told the press
// was registered, so anything past it is deliberate rather than a slow finger.
static const int BTN_OFF_MS = 10000;

// How long the question stays on the glass before it answers itself with "no". Long enough to read
// four lines and decide, short enough that a press nobody meant does not leave the device asking.
static const int OFF_CONFIRM_S = 30;

static void wait_button_release(const char *what)
{
    int held = 0;
    while (gpio_get_level(PIN_USER_BTN) == 0 && held < 10000) {
        vTaskDelay(pdMS_TO_TICKS(20)); held += 20;
        if ((held % 2000) == 0) esp_task_wdt_reset();
    }
    if (held >= 10000)
        ESP_LOGW(TAG, "button still down after 10 s (%s) — carrying on without it", what);
}

// The last steps of every sleep, in the order they have to happen. The caller has already armed its
// pins with arm_wake_pins(), which clears every wake source first, so the timer is set here, after it;
// a timer of 0 leaves the pins as the only way back. `flush_log` gives the last lines 200 ms to reach
// a serial monitor.
[[noreturn]] static void enter_deep_sleep(uint64_t timer_us, bool flush_log)
{
    if (timer_us) esp_sleep_enable_timer_wakeup(timer_us);
    esp_task_wdt_delete(NULL);          // going to sleep on purpose is not a hang
    if (flush_log) vTaskDelay(pdMS_TO_TICKS(200));
    boot_reached_sleep();               // last: it commits a pending image and stamps the sleep
    esp_deep_sleep_start();
}

// Everything this file keeps in RTC memory about the device's life: readings, weather, schedule,
// alerting, the panel's last frame, the button's history. RTC_NOINIT survives sleep, esp_restart and
// a reflash, so nothing here goes away just because the device stopped being configured.
//
// NOT touched, on purpose: the build stamp and the boot counter, which describe the image rather than
// the device's past; rtc_panel_powered, which describes the panel as it physically is right now and
// has already been acted on this boot; the factory-reset marker, which belongs to its caller; and the
// sleep-latency trims, which are a property of this board, not of anybody's use of it.
// Everything the outdoor weather left behind, back to "never fetched".
//
// It is a function because TWO paths need it and they must not drift: a factory reset, and an image
// change. The second one is why this exists at all. RTC variables move to new addresses on every
// rebuild, so a field not reset there reads whatever the old layout left at that address — and the
// strip's cells are sentinel-guarded, which makes garbage worse than a zero would be: a large
// random int passes the "was it ever fetched" test and the clamp that keeps snprintf inside eight
// bytes then renders it as a plausible 999. That is exactly what shipped in 0.10.16 and what the
// owner saw: three nines in the UV, rain and cloud cells after an over-the-air update.
//
// Resetting on an image change costs today's accumulated high and low, and one radio window with
// dashes instead of weather. Both are cheap against a number nobody can tell is wrong.
static void forget_weather(void)
{
    rtc_wx_failed = false;
    rtc_wx_city[0] = rtc_wx_desc[0] = rtc_wx_icon[0] = '\0';
    rtc_wx_temp = rtc_wx_feels = rtc_wx_wind = 0; rtc_wx_hum = 0;
    rtc_wx_uv = -1.0f; rtc_wx_dew = -999.0f; rtc_wx_cloud = -1;
    // The +-999 sentinels, not zero: 0 C is a temperature a day can genuinely have (see mmok).
    rtc_wx_lo = 999.0f; rtc_wx_hi = -999.0f;
    rtc_day_lo = 999.0f; rtc_day_hi = -999.0f; rtc_day_stamp = 0;
    memset(rtc_fc, 0, sizeof(rtc_fc));   // the outlook was for the old owner's city
}

static void forget_rtc_state(void)
{
    rtc_magic = 0; rtc_tick = 0; rtc_bsec_ns = 0; rtc_bsec_wall_us = 0;
    rtc_last_weather = rtc_last_wx_try = rtc_last_fc = rtc_last_meas = rtc_last_co2 = 0;
    rtc_last_hist = 0; rtc_met_expires = 0;
    rtc_wifi_fail = false; rtc_wifi_fails = 0; rtc_wifi_skip = 0;
    rtc_pres_pa = 0; rtc_pres_miss = 0;
    rtc_co2 = 0; rtc_co2_fails = 0;   // a wiped device is not a broken one
    rtc_temp = rtc_hum = rtc_iaq = rtc_soc = rtc_soc_raw = 0; rtc_acc = 0;
    rtc_volt = rtc_crate = 0;
    rtc_bat_ttf = 0;
    rtc_bat_cycles = 0; rtc_bat_state = 0; rtc_bat_alerts = 0; rtc_bat_notified = 0;
    rtc_b_temp = rtc_b_hum = 0;
    rtc_gas_ohm = rtc_siaq = rtc_gasp = 0; rtc_stab = rtc_runin = 0;
    rtc_bsec_nvs_at = 0; rtc_bsec_nvs_acc = 255;
    rtc_toff_applied = -999.0f; rtc_co2_diag[0] = '\0';
    rtc_lockout = false; rtc_lock_drawn = false;
    rtc_pres_mode = 0; rtc_ptrend = 0;
    rtc_class = 0; rtc_air_class = 0; rtc_cls_txt[0] = '\0';
    rtc_alert = AlertState{}; rtc_alert_tier = 0; rtc_alert_confirmed = 0; rtc_alert_co2 = 0; rtc_alert_iaq = 0; rtc_alert_at = 0;
    rtc_msg_co2 = 0; rtc_msg_iaq = rtc_msg_temp = rtc_msg_hum = 0.0f; rtc_msg_acc = 0;
    rtc_msg_srh = rtc_msg_out = NAN;
    rtc_al_title[0] = rtc_al_text[0] = rtc_al_level[0] = '\0'; rtc_al_tries = 0;
    rtc_al_seq = rtc_al_hub = 0;
    rtc_blind_wakes = 0;
    forget_weather();
    rtc_prev_valid = false; rtc_prev = Frame{};
    rtc_last_full = 0; rtc_partials = 0; rtc_ink_blocked = false; rtc_logo_shown = false;
    rtc_mqtt_disco_at = 0;
    rtc_was_night = false; rtc_night_began = 0;
    rtc_ns_co2_max = rtc_ns_co2_avg = 0; rtc_ns_t_min = rtc_ns_t_max = rtc_ns_h_max = 0;
    rtc_ns_from = rtc_ns_to = 0;
    rtc_usb_spurious = 0; rtc_btn_noise = 0;
    rtc_btn_pending = false; rtc_btn_held_ms = 0; rtc_btn_ghosts = 0;
    rtc_portal_unused = 0;
    BSECManager::invalidateRtcState();   // the gas calibration starts again, in its new room
}

// Everything this device remembers, in every place it keeps it, with one deliberate exception.
// "Erase everything" on this device is a list, not a call: NVS, the measurement ring, the flight
// recorder, the crash dump and RTC memory are separate stores. The reset this replaces wiped NVS and
// left the rest to whatever a later boot decided — which, whenever the history happened to be empty,
// was nothing at all for the flight recorder and the crash dump.
//
// KEPT: the CO2 sensor's forced recalibration. It lives in the sensor's own EEPROM, it corrects that
// physical sensor rather than recording anybody's use of it, and it survives this reset the way it
// survives a battery swap. Nothing here sends the sensor a command. The temperature offset is kept
// too: with "scd_toff" gone, the first measurement takes the sensor's own value into NVS rather than
// writing the default over it (measure()).
//
// Runs at the start of the boot that follows the request, before anything reads the old state. The
// order survives a power cut: the NVS marker that asked for this is the LAST thing erased, so a wipe
// that is interrupted simply runs again on the next boot.
static void factory_wipe(void)
{
    led(true);                                   // somebody asked for this and is waiting for it
    ESP_LOGW(TAG, "FACTORY RESET — erasing everything this device remembers (CO2 and temperature calibration kept)");
    const int64_t t0 = esp_timer_get_time();

    forget_rtc_state();
    // The wall clock itself stays: it is the time, not anybody's data, and a set clock is what lets
    // the next owner's first readings carry dates. Its sync stamp goes, so the next network earns it.
    ClockSync::getInstance().forceClockSync();

    HistStore::getInstance().init();
    HistStore::getInstance().eraseAll();
    EvtLog::getInstance().init();
    EvtLog::getInstance().eraseAll();
    // The crash dump is a snapshot of RAM, and the owner's Wi-Fi name has been read out of one with
    // `strings` before; their password, weather key and bot token live in the same memory.
    {
        const esp_err_t ce = esp_core_dump_image_erase();
        ESP_LOGW(TAG, "crash dump partition: %s", ce == ESP_OK ? "erased" : esp_err_to_name(ce));
    }
    esp_task_wdt_reset();

    // The temperature calibration is carried ACROSS the erase, the way the CO2 one already survives
    // it (owner's decision 2026-09-11 for CO2, 2026-09-27 for temperature). Both are corrections for
    // THIS sensor in THIS enclosure — a property of the device, not of the owner, and the next person
    // to hold it wants a device that reads true, not one that has forgotten how.
    //
    // CO2 survives for free: its correction lives in the SCD41's own EEPROM and the firmware never
    // sends the sensor a factory reset. Temperature's lives in NVS, which is about to go whole, so
    // it is read out here and written back below.
    //
    // The sensor's EEPROM also holds a copy, and scd_sync_offset() adopts it when NVS has nothing —
    // but only if the sensor answers at the first measurement after the wipe. Until it does, the
    // console shows the 4.00 C default, which reads as "never calibrated" rather than "ask again in
    // a minute". Carrying the number keeps it true from the first boot, and the EEPROM copy stays as
    // the second line of defence for a flash erased some other way.
    float keep_toff = 0.0f;
    const bool have_toff = NVSManager::getInstance().getFloat("scd_toff", keep_toff, 4.0f)
                           && keep_toff >= 0.0f && keep_toff <= 20.0f;

    // The cell's gain correction rides across for exactly the same reason, and with a sharper edge:
    // it has no copy anywhere else. Temperature can be recovered from the sensor's own EEPROM and
    // CO2 never leaves it, but this number describes the resistors and the converter on THIS board
    // and lives only here. Losing it to a factory reset would silently move the cutoff — on the v2
    // board measured on 2026-09-29 the device would start guarding a cell at 3.24 V while believing
    // it guarded one at 3.30 — and nothing on the screen would say so.
    float keep_cal = 0.0f;
    const bool have_cal = NVSManager::getInstance().getFloat("bat_cal", keep_cal,
                                                             BatterySource::CAL_NONE)
                          && keep_cal >= BatterySource::CAL_MIN
                          && keep_cal <= BatterySource::CAL_MAX
                          && keep_cal != BatterySource::CAL_NONE;

    // The gain is cached for the boot, and the key it was cached from is about to go. Dropping it
    // here means the write-back below is what the device ends up using — and that a write-back that
    // FAILS leaves the device honestly uncalibrated rather than applying a number it no longer has.
    BatterySource::forgetBoard();

    // NVS last. It holds the request, so erasing it is what marks the wipe as done. Erased whole
    // rather than key by key: Wi-Fi's own namespace, the radio calibration, anything a later version
    // adds, all of it goes without this list having to know about it.
    esp_err_t ne = nvs_flash_erase();
    if (ne == ESP_OK) ne = nvs_flash_init();
    if (ne == ESP_OK) {
        // Written back before anything else can run: a boot that finds nothing here takes the
        // sensor's EEPROM value instead, and the two must not race to decide which one wins.
        if (have_toff) {
            if (NVSManager::getInstance().setFloat("scd_toff", keep_toff))
                ESP_LOGW(TAG, "temperature calibration %.2f C kept across the reset", keep_toff);
            else
                ESP_LOGE(TAG, "temperature calibration %.2f C could NOT be written back — the "
                              "sensor's own copy is the fallback", keep_toff);
        }
        if (have_cal) {
            if (NVSManager::getInstance().setFloat("bat_cal", keep_cal))
                ESP_LOGW(TAG, "cell voltage gain %.4f kept across the reset", keep_cal);
            else
                ESP_LOGE(TAG, "cell voltage gain %.4f could NOT be written back — this board now "
                              "reads its cell uncalibrated and must be measured again", keep_cal);
        }
        rtc_factory_req = 0;
    s_sec_note[0] = '\0'; s_sec_tries = 0;   // RTC now: garbage here would be sent as a notice
    } else {
        ESP_LOGE(TAG, "NVS erase FAILED (%s) — the wipe will run again on the next boot",
                 esp_err_to_name(ne));
    }
    // The first record of the fresh log says why it is fresh.
    EvtLog::getInstance().event(EVT_NOTE, NOTE_FACTORY_WIPE);
    ESP_LOGW(TAG, "factory reset done in %lld ms", (long long)((esp_timer_get_time() - t0) / 1000));
}

// What this device calls itself in messages. With more than one in the house, "Smart Meteo says the
// air is bad" is useless — the whole point of the notification is knowing which room to walk into.
// Empty (the default) falls back to the product name, so a single device reads exactly as before.
//
// Deliberately NOT wired to the access point's name: the setup QR is a baked-in picture that
// encodes the fixed SSID and password, so renaming the network would leave the QR pointing at a
// network that no longer exists (CLAUDE.md 4.27).
static const char *device_name(char *buf, size_t n)
{
    std::string s;
    NVSManager::getInstance().getString("dev_name", s, "");
    if (s.empty()) return "Smart Meteo";
    snprintf(buf, n, "%s", s.c_str());
    return buf;
}

// When a reading was taken, on the owner's clock (NVS tz_h, the offset the screen uses): "14:05", or
// "13.09 14:05" when it was not today. Empty while the clock has never been set — a message then says
// nothing about time rather than print 1970.
static const char *local_stamp(time_t t, char *buf, size_t n)
{
    buf[0] = '\0';
    const time_t now = time(NULL);
    if (t < 1600000000 || now < 1600000000) return buf;
    float tz = 0; NVSManager::getInstance().getFloat("tz_h", tz, 0.0f);
    const time_t off = (time_t)lroundf(tz * 3600.0f);
    const time_t lt = t + off, ln = now + off;
    struct tm a, b; gmtime_r(&lt, &a); gmtime_r(&ln, &b);
    // Each field is taken modulo 100 so the compiler can see what a reader already knows: these are
    // two-digit fields, and the longest this writes is "dd.mm HH:MM" — eleven characters and a
    // terminator. Without it GCC has to assume an int can print eleven digits, and at -Os, where it
    // inlines enough to look, it refuses the whole file over a truncation that cannot happen.
    const int mday = a.tm_mday % 100, mon = (a.tm_mon + 1) % 100;
    const int hour = a.tm_hour % 100, min = a.tm_min % 100;
    if (a.tm_year == b.tm_year && a.tm_yday == b.tm_yday)
        snprintf(buf, n, "%02d:%02d", hour, min);
    else
        snprintf(buf, n, "%02d.%02d %02d:%02d", mday, mon, hour, min);
    return buf;
}

// Temperature and pressure in the units the owner chose for the screen (NVS u_temp, u_pres).
static const char *fmt_temp(float c, char *buf, size_t n)
{
    uint8_t u = UNIT_TEMP_DEFAULT; NVSManager::getInstance().getU8("u_temp", u, UNIT_TEMP_DEFAULT);
    snprintf(buf, n, "%.1f \xC2\xB0%c", u ? c * 9.0f / 5.0f + 32.0f : c, u ? 'F' : 'C');
    return buf;
}
static const char *fmt_pres(float pa, char *buf, size_t n)
{
    uint8_t u = UNIT_PRES_DEFAULT; NVSManager::getInstance().getU8("u_pres", u, UNIT_PRES_DEFAULT);
    if (pa <= 30000.0f) snprintf(buf, n, "no reading");   // a dead barometer channel, as on the screen
    else if (u)         snprintf(buf, n, "%.0f mmHg", pa * 0.00750062f);
    else                snprintf(buf, n, "%.0f hPa", pa / 100.0f);
    return buf;
}

// Read by the MQTT payload builder, which lives in another file and must not reach into RTC
// variables directly.
const char *alert_title() { return rtc_al_title; }
const char *alert_text()  { return rtc_al_text; }
const char *alert_level() { return rtc_al_level[0] ? rtc_al_level : "clear"; }

// The alert state machine, for the console. Nothing here changes behaviour — it exists because the
// first real end-to-end alert (2026-08-11) arrived LATE and there was no way to see why: the status
// reported the air class and nothing about the machine that decides whether to speak. A class is
// only believed after it holds for two ticks, and a message only leaves once the radio is up, so
// "nothing arrived" has at least four distinct causes that look identical from outside.
int alert_cand_class()    { return rtc_alert.cand_class; }
int alert_cand_count()    { return rtc_alert.cand_count; }
int alert_notified()      { return rtc_alert.notified_class; }
int alert_confirmed()     { return rtc_alert_confirmed; }
int alert_tier()          { return (int)rtc_alert_tier; }
int alert_tries_left()    { return (int)rtc_al_tries; }
long alert_last_notify()  { return (long)rtc_alert.last_notify; }
int alert_co2_latched()   { return rtc_alert.co2_latched ? 1 : 0; }
int alert_damp_latched()  { return rtc_alert.damp_latched ? 1 : 0; }

// One place decides how the panel is left for the sleep, so the three sites cannot drift apart.
// hibernate() puts the controller itself away first either way; what differs is whether its rail
// survives. When the rail is cut, every signal line goes to high impedance rather than being
// grounded — established by bisection in panel_bench.cpp and prescribed by the controller's own
// datasheet. Grounding them left the rail sagging through the region where the controller is alive
// but no longer sane, and it disturbed the pixels on the way down.
static bool s_panel_put_away = false;   // panel_to_sleep() has run this boot

static void panel_to_sleep(EPaper &epd, PanelSleep how = PanelSleep::Powered)
{
    s_panel_put_away = true;
    if (how == PanelSleep::Parked) {
        // Do not wake it just to put it back to sleep. If the rail is already down, the hibernate
        // command would clock SPI into an unpowered panel — feeding it through the ESD diodes we
        // are trying to keep quiet — and bringing the rail up first would spend a second crossing
        // for nothing. Re-latching the gate is the whole job on an hourly wake that drew nothing.
        // Whether the panel is up is a question about NOW, not about how the last sleep left it.
        // init() switches the rail on as a side effect, so any wake that drew has a live panel
        // regardless of the flag — and reading the flag alone cut the supply with no sleep command
        // and no settle at all, which is precisely the thing the vendor calls mandatory. The flag
        // still carries the other case: a wake that drew nothing, on a panel left powered earlier.
        if (epd.isUp() || epd.asleep() || rtc_panel_powered) {
            // A picture drawn this wake already ended with the sleep command (draw()); sending it again
            // would first take the hardware reset that wakes the controller. Otherwise wake it to say it.
            if (!epd.asleep()) {
                epd.init();      // without it there is no SPI to speak the command on
                epd.hibernate();
            }
            // The panel maker's own instruction, and the piece we were missing when cutting the
            // rail greyed the glass overnight: entering sleep is mandatory before power removal,
            // and if that alone does not hold, leave 2-3 seconds between the two. The controller
            // runs its own boosted rails — VGH near +20 V, VGL near -20 V, VCOM — and after the
            // sleep command it needs that long to bring them down in order. Cut sooner and the
            // charge is still on the electrodes when the supply goes, which is the greying.
            //
            // It also explains the asymmetry that started this: pulling the battery does NOT harm
            // the image, because by then the last frame is hours old and those rails are long
            // settled. Our switch was cutting microseconds after the sleep command.
            //
            // Paid once per park, not per wake — a wake that finds the panel already off skips
            // this whole branch.
            vTaskDelay(pdMS_TO_TICKS(PANEL_SETTLE_MS));
            EPaper::holdOffForDeepSleep();

            // And now let the rail finish falling before ANY caller arms a wake pin.
            //
            // Without this the logo screen became an infinite loop: park, arm the button, sleep,
            // and the collapsing rail put an edge on the button line within milliseconds. The
            // device read it as a press, opened the setup screen, timed out after three minutes,
            // drew the logo, parked again — round and round, with the radio up half the time.
            //
            // The coupling is not a guess: 4.65 measured it. Every rejected edge on that line came
            // from a wake that drove the panel, and 450 wakes that left it alone produced exactly
            // zero. Switching the panel's supply is what disturbs the button.
            //
            // Three seconds against a measured two-second decay, and it is paid once per park —
            // a wake that finds the panel already off never enters this branch.
            vTaskDelay(pdMS_TO_TICKS(RAIL_QUIET_MS));
        } else {
            // Already off: re-latch the gate for the coming sleep. Nothing switches, so nothing
            // is disturbed and there is nothing to wait for.
            EPaper::holdOffForDeepSleep();
        }
        rtc_panel_powered = false;
        // The baseline a partial refresh is laid over lives in the panel's own RAM, and that RAM
        // sits on the rail that just went. Whatever is drawn next has nothing to differ from, so
        // it has to be a full refresh — the morning one, or a press at three in the morning.
        rtc_prev_valid = false;
        return;
    }
    epd.hibernate();
    EPaper::holdForDeepSleep();
    rtc_panel_powered = true;
}

// esp_restart() runs every handler registered with esp_register_shutdown_handler() before the reset
// (esp_system.h). A restart the cycle itself makes — an update installed in a radio window — then leaves
// the panel as a sleep does: the vendor's sleep command if the controller is awake, and its supply latched
// on, since a pad hold is kept through a reset (gpio_hold_en, driver/gpio.h). Not when this boot has
// already put the panel away, and not for a panel parked with its supply off and untouched since.
//
// Only on the cycle task, the one that drives the panel. esp_restart() is also called from the httpd task
// (the Restart button, /api/ota) and from the console's install task, and EPaper has no lock: a sleep
// command sent from there could interleave with a frame the cycle task is sending, DC line included. Those
// restarts happen inside a setup window, where every frame already ends with the sleep command (draw(),
// draw_dashboard()).
static EPaper      *s_restart_panel = nullptr;
static TaskHandle_t s_restart_owner = nullptr;
static void panel_before_restart(void)
{
    if (!s_restart_panel || s_panel_put_away) return;
    if (xTaskGetCurrentTaskHandle() != s_restart_owner) return;
    if (!s_restart_panel->isUp() && !s_restart_panel->asleep() && !rtc_panel_powered) return;
    panel_to_sleep(*s_restart_panel, PanelSleep::Powered);
}

// Records an event in the words the owner will actually read. Everything that notifies goes
// through here, so the wording cannot drift between the channels that deliver it.
// Returns false when it refused, which means the previous alert is still owed a delivery. The slot
// is one entry deep, so taking a new event here would silently destroy an undelivered one — and the
// air alert is edge-triggered, so once destroyed it can never be regenerated. A caller whose own
// event is edge-triggered too MUST NOT mark it as handled when this returns false.
static bool set_alert(const char *level, const char *title, const char *text)
{
    if (rtc_al_tries) {
        ESP_LOGW(TAG, "alert [%s] %s held back: '%s' is still owed %u delivery attempt(s)",
                 level, title, rtc_al_title, (unsigned)rtc_al_tries);
        return false;
    }
    snprintf(rtc_al_level, sizeof(rtc_al_level), "%s", level);
    snprintf(rtc_al_title, sizeof(rtc_al_title), "%s", title);
    snprintf(rtc_al_text,  sizeof(rtc_al_text),  "%s", text);
    rtc_al_tries = 3;      // this text is owed a delivery; see rtc_al_tries
    rtc_al_seq++;          // ...and the hub is owed the event; see rtc_al_seq
    ESP_LOGW(TAG, "alert [%s] %s | %s", level, title, text);
    return true;
}

// Hand whatever is owed to Telegram. Called immediately after each set_alert() that can be
// followed by another one in the same window: the air alert and the low-battery warning are
// separate events, and the second used to overwrite the first before either had been sent —
// so a device that went below 15 % during a gas event reported only the battery.
// ---- telling the owner about the device itself ------------------------------------------------
//
// EN 18031-2 [UNM] asks that the user be told about changes affecting the protection of their
// information. Three things qualify and are worth a message: the device password was changed, a
// firmware update went in, and a factory reset was asked for. The person who did it knows already —
// the message is for the case where they did not.
//
// Sign-ins are deliberately NOT sent. Somebody opening the console is standing in front of the
// device with its screen in view, and a message for every session becomes noise, and noise is what
// makes the three that matter get ignored.
//
// The text is queued rather than sent at the moment it happens: these events arrive on the httpd
// task, and Telegram is a TLS handshake and a request on a stack that belongs to a web handler. The
// cycle picks it up — inside the console window it goes out within seconds, otherwise at the next
// radio window.

extern "C" void smart_meteo_security_note(const char *text)
{
    snprintf(s_sec_note, sizeof(s_sec_note), "%s", text);
    s_sec_tries = 3;
}

static void deliver_security_note()
{
    // Terminated defensively: this buffer is RTC memory, which is garbage until
    // forget_rtc_state() clears it, and a missing NUL here would be read past the array.
    s_sec_note[sizeof(s_sec_note) - 1] = '\0';
    if (!s_sec_tries || !s_sec_note[0]) return;
    uint8_t wl_mode = 0, tg_en = 0;
    NVSManager::getInstance().getU8("wl_mode", wl_mode, 0);
    NVSManager::getInstance().getU8("tg_en", tg_en, 0);
    // In Matter mode there is no Telegram and no outbound path of our own; the hub owns messaging.
    if (wl_mode > 1 || !tg_en) { s_sec_tries = 0; s_sec_note[0] = '\0'; return; }
    std::string tok, chat;
    NVSManager::getInstance().getString("tg_tok", tok, "");
    NVSManager::getInstance().getString("tg_chat", chat, "");
    if (tok.empty() || chat.empty()) { s_sec_tries = 0; s_sec_note[0] = '\0'; return; }

    std::string dev;
    NVSManager::getInstance().getString("dev_name", dev, "");
    char text[320];
    snprintf(text, sizeof(text), "\xF0\x9F\x94\x92 %s: %s",
             dev.empty() ? "Smart Meteo" : dev.c_str(), s_sec_note);
    if (Telegram::send(tok, chat, text)) {
        ESP_LOGW(TAG, "security notice sent: %s", s_sec_note);
        s_sec_tries = 0;
        s_sec_note[0] = '\0';
    } else if (--s_sec_tries == 0) {
        ESP_LOGE(TAG, "security notice could not be sent, giving up: %s", s_sec_note);
        s_sec_note[0] = '\0';
    }
}

static void deliver_alert()
{
    if (!rtc_al_tries) return;
    uint8_t wl_mode = 0, tg_en = 0;
    NVSManager::getInstance().getU8("wl_mode", wl_mode, 0);
    NVSManager::getInstance().getU8("tg_en", tg_en, 0);
    if (wl_mode > 1 || !tg_en) { rtc_al_tries = 0; return; }   // hub-only, or Telegram switched off
    std::string tok, chat;
    NVSManager::getInstance().getString("tg_tok", tok, "");
    NVSManager::getInstance().getString("tg_chat", chat, "");
    if (tok.empty() || chat.empty()) {
        rtc_al_tries = 0;
        ESP_LOGW(TAG, "alert to send, but no Telegram token/chat configured");
        return;
    }
    if (Telegram::send(tok, chat, rtc_al_text)) {
        rtc_al_tries = 0;
    } else {
        rtc_al_tries--;
        ESP_LOGE(TAG, "Telegram send FAILED (%u attempt(s) left)", (unsigned)rtc_al_tries);
    }
}

// The owner's alert settings. The save handler stores the CO2 level as an integer: reading it as a float
// fails on the type and hands back the default, which would ignore the level the owner chose.
static AlertConfig load_alert_config()
{
    AlertConfig cfg;
    uint8_t u8 = 1; uint32_t lvl = CO2_ALERT_DEFAULT;
    NVSManager::getInstance().getU32("al_co2", lvl, CO2_ALERT_DEFAULT);
    if (lvl < CO2_ALERT_MIN) lvl = CO2_ALERT_MIN;
    if (lvl > CO2_ALERT_MAX) lvl = CO2_ALERT_MAX;
    cfg.co2_level = (uint16_t)lvl;
    NVSManager::getInstance().getU8("al_co2en", u8, 1); cfg.co2_en = u8;
    NVSManager::getInstance().getU8("al_voc",   u8, 1); cfg.voc_en = u8;
    NVSManager::getInstance().getU8("al_hum",   u8, 1); cfg.hum_en = u8;
    return cfg;
}

// Which low-battery warning is due, if any: 15, 10, 5, or 0 for none.
//
// Returns the LOWEST threshold that has been crossed and not yet announced, so a device that was
// asleep while the charge fell from 18 % to 4 % says "5 %" once rather than working through all
// three. Each level is announced a single time; they re-arm together once the cell is back above
// 20 %, which also covers a swapped battery.
#define BAT_WARN_1 15
#define BAT_WARN_2 10
#define BAT_WARN_3  5
static bool usb_present(void);   // defined further down, with the rest of the power handling
static int battery_alert_level(void)
{
    if (rtc_soc <= 0.0f) return 0;              // no reading yet — nothing to judge
    // Not while it is charging. These messages exist to say "go and plug it in", and the owner has
    // already done that — a device on the cable at 12 % would raise the radio off-schedule to tell
    // its owner to connect the USB power that is currently connected. The thresholds re-arm above
    // 20 % anyway, so a cable that stays in simply means they are never needed.
    if (usb_present()) return 0;
    const int soc = (int)(rtc_soc + 0.5f);
    if (soc <= BAT_WARN_3 && !(rtc_bat_notified & 4)) return BAT_WARN_3;
    if (soc <= BAT_WARN_2 && !(rtc_bat_notified & 2)) return BAT_WARN_2;
    if (soc <= BAT_WARN_1 && !(rtc_bat_notified & 1)) return BAT_WARN_1;
    return 0;
}

// Draw one 4-gray picture and report what actually happened.
// A four-gray picture is not the dashboard, so the same bookkeeping surrounds every one of them:
// the baseline is void afterwards, the elapsed time says whether the transfer really happened, and
// the panel is put to sleep as Good Display ask. Split in two so that the compressed pictures and
// the one composed at run time share it instead of carrying a copy each.
static int64_t draw_begin(const char *name)
{
    // Anything that is NOT the dashboard (logo, QR setup screen) voids the dashboard baseline:
    // the glass no longer holds the frame those saved values describe. The next dashboard must
    // therefore be a FULL refresh — a partial one would compute its differences against a frame
    // that is not there and lay the new readings over the picture that is.
    rtc_prev_valid = false; rtc_prev = Frame{};
    // "LOGO" exactly. The test was the first two letters, and "LOW BATTERY" begins with them too.
    rtc_logo_shown = (strcmp(name, "LOGO") == 0);
    ESP_LOGW(TAG, "drawing %s ...", name);
    return esp_timer_get_time();
}

static void draw_finish(EPaper &epd, const char *name, int64_t t0)
{
    const long long ms = (esp_timer_get_time() - t0) / 1000;
    ESP_LOGW(TAG, "%s drawn in %lld ms | BUSY=%d | free heap %u",
             name, ms, gpio_get_level(EPD_BUSY_PIN), (unsigned)esp_get_free_heap_size());
    // The white frame, a sleep command and the vendor's two seconds come first (display4Gray), so a
    // healthy draw takes well over this and one whose transfer went nowhere does not.
    if (ms < 4000) ESP_LOGE(TAG, "TOO FAST — the refresh did not really run");
    if (!epd.sessionOk()) ESP_LOGE(TAG, "%s: SPI error or BUSY timeout — the picture may be incomplete", name);
    // Good Display's tips in GDEY042T81_Arduino.ino ask that the panel enter sleep mode when the refresh
    // is completed, and their demo sends EPD_DeepSleep() after every frame. The setup window that follows
    // a picture can keep the device awake for a quarter of an hour.
    epd.hibernate();
}

// The setup screen, composed into planes at run time.
static void draw(EPaper &epd, const char *name, const uint8_t *p24, const uint8_t *p26)
{
    const int64_t t0 = draw_begin(name);
    epd.display4Gray(p24, p26);
    draw_finish(epd, name, t0);
}

// The three pictures that ship in the image: logo, LOW BATTERY and the bare setup screen. They are
// run-length coded and expanded a plane at a time inside the driver — no buffer to find here.
static void draw_rle(EPaper &epd, const char *name,
                     const uint8_t *r24, size_t n24, const uint8_t *r26, size_t n26)
{
    const int64_t t0 = draw_begin(name);
    epd.display4GrayRle(r24, n24, r26, n26);
    draw_finish(epd, name, t0);
}

// The Wi-Fi setup screen for this device: the picture with its own access-point password and the QR
// code that carries it. Composed in two heap planes rather than static ones — thirty kilobytes of
// .bss would come out of the heap in every mode, for a screen most wakes never draw.
//
// bat, when given, goes in the top-right corner the way the dashboard draws it (owner, 2026-10-29:
// whoever switches the device on should see where the charge stands). nullptr leaves the corner as
// the picture has it — safe mode, which must not touch the bus, and a cell nobody could read.
static void draw_setup_screen(EPaper &epd, const char *name, const PortalScreen::Battery *bat)
{
    uint8_t *p24 = (uint8_t *)heap_caps_malloc(PortalScreen::kPlaneBytes, MALLOC_CAP_8BIT);
    uint8_t *p26 = (uint8_t *)heap_caps_malloc(PortalScreen::kPlaneBytes, MALLOC_CAP_8BIT);
    if (p24 && p26 && PortalScreen::compose(p24, p26, BENCH_AP_SSID, WiFiManager::apPassword())) {
        if (bat) PortalScreen::drawBattery(p24, p26, *bat);
        draw(epd, name, p24, p26);
    } else {
        // Still the instructions and the network name; without the password nobody can join, so
        // this is logged as the failure it is.
        ESP_LOGE(TAG, "%s: setup screen not composed (%s) — drawing it without QR and password", name,
                 (p24 && p26) ? "QR or glyph refused" : "no memory");
        draw_rle(epd, name, portal_art_plane24_rle, PORTAL_ART_PLANE24_RLE_LEN,
                 portal_art_plane26_rle, PORTAL_ART_PLANE26_RLE_LEN);
    }
    heap_caps_free(p24);
    heap_caps_free(p26);
}

// Park the sensors in their lowest state. Until the device has been set up there is nothing to
// measure for, and "we never talk to them" is NOT the same as "they are off": they sit on the
// 3.3 V rail permanently (there is no power switch — a deliberate design choice), and the CO2
// sensor idles far above its sleep figure until it is explicitly told to power down. Same for
// the fuel gauge, whose low-power mode has to be asked for. The gas sensor already boots asleep.
static void park_sensors(void)
{
    I2CManager::getInstance().init();
    i2c_master_bus_handle_t bus = I2CManager::getInstance().getBusHandle();
    if (!bus) { ESP_LOGW(TAG, "no I2C bus — cannot park the sensors"); return; }

    SCD41 scd;
    // power_down takes the sensor from IDLE to sleep (SCD4x datasheet v1.7 §3.11.3). wakeToIdle()
    // gets it there first from whatever it was left in: asleep, idle, or measuring periodically.
    if (scd.init(bus)) {
        if (scd.wakeToIdle() && scd.powerDown()) ESP_LOGW(TAG, "CO2 sensor parked (power down)");
        else                                     ESP_LOGW(TAG, "CO2 sensor did not reach idle / power down");
    } else {
        ESP_LOGW(TAG, "CO2 sensor did not answer — cannot park it");
    }

    BatterySource::park(bus);
}

// The settings the Mode tab writes, read back on every wake. The tab promises specific intervals;
// this is what makes the device keep that promise.
//
// Scheduling is by WALL CLOCK, not by counting wakes. A counter drifts here because wakes are not
// all scheduled: the button and the USB cable both wake the device, and every one of those would
// otherwise shift the cadence the user was shown.
struct Plan {
    uint8_t  profile   = 1;      // 0 Performance / 1 Optimal / 2 Ultra Save / 3 Custom
    bool     night     = false;
    bool     no_net    = false;  // the owner set this device up without a network at all
    uint32_t meas_min  = 5;      // CO2 + gas interval in force right now
    uint32_t radio_min = 30;     // network interval; 0 = radio off entirely
    bool     live_clock = true;  // repaint every minute, or only when something was measured
    bool     offline    = false; // radio off by configuration: there will never be weather
    bool     matter     = false; // Matter over Thread: no Wi-Fi at all outside a console session
};

// How long ago, short enough for the tag next to a reading. The screen promises freshness with
// these, so they have to be real: a permanent "now" beside a two-hour-old number is a lie the user
// cannot detect. Below a minute and a half it reads "now" — the tag updates once a minute at best,
// so finer than that would be false precision.
static void fmtAge(time_t age, char *out, size_t n)
{
    if (age < 0)        snprintf(out, n, "now");
    else if (age < 90)  snprintf(out, n, "now");
    else if (age < 5400) snprintf(out, n, "%dm", (int)((age + 30) / 60));
    else if (age < 172800) snprintf(out, n, "%dh", (int)((age + 1800) / 3600));
    else                snprintf(out, n, "%dd", (int)(age / 86400));
}

// Night can wrap past midnight (23 -> 7), so it is not a simple range test.
static bool inNight(int hour, int from, int to) {
    if (from == to) return false;
    return (from < to) ? (hour >= from && hour < to) : (hour >= from || hour < to);
}


// One snapshot of everything the gas algorithm needs to wake up knowing what it knew. The four keys
// are only meaningful TOGETHER: the state blob without its clock hands the next boot a timeline
// running backwards and it drops the run-in. Written from two places, the hourly backup and the
// moment before an update takes over, and it exists as a function precisely so those two cannot
// drift apart.
//
// Refuses when BSEC did not run this wake. A snapshot taken where the algorithm never initialised
// is not a snapshot of anything, and writing one over a good backup is how 4.32 destroyed a real
// calibration.
static bool save_calibration_snapshot(uint8_t acc, const char *why)
{
    if (!BSECManager::getInstance().isRunning()) {
        ESP_LOGW(TAG, "calibration snapshot skipped (%s): the gas algorithm did not run this wake",
                 why);
        return false;
    }
    if (!BSECManager::getInstance().saveStateNVS()) return false;
    const time_t wall_now = time(NULL);
    NVSManager &n = NVSManager::getInstance();
    n.setU8("bsec_acc", acc);                       // what the backup is worth
    // Wall time of the snapshot. The gas clock is virtual and only advances while we run, so
    // restoring it later would hand the algorithm a timeline with the gap missing. Knowing WHEN it
    // was taken lets the gap be added back on the other side.
    n.setU32("bsec_wall", (uint32_t)(wall_now > 1600000000 ? wall_now : 0));
    n.setU32("bsec_clk",  (uint32_t)(rtc_bsec_ns / 1000000000LL));
    rtc_bsec_nvs_at  = wall_now > 1600000000 ? wall_now : 1600000001;
    rtc_bsec_nvs_acc = acc;
    ESP_LOGW(TAG, "gas calibration backed up to flash (acc %u/3) — %s", acc, why);
    return true;
}

// Called by ota_install.cpp when an update has been written and the device is about to restart
// into it, from either path — the scheduled window or the console button. A hook because the state
// that has to survive an update lives here, not in the installer; and it is the same call the
// scheduled path makes, so the two endings cannot drift apart.
extern "C" void smart_meteo_ota_handoff(void)
{
    save_calibration_snapshot(rtc_acc, "handing over to a new image");
}

// What the console's "Running now" card reads. It promises to report the device rather than the
// saved settings, so it has to be refreshed whenever the device's answer could have changed —
// which inside an open setup window is every time somebody saves something.
static void publish_plan(const Plan &p)
{
    global_plan_profile    = p.profile;
    global_plan_night      = p.night;
    global_plan_meas_min   = p.meas_min;
    global_plan_radio_min  = p.radio_min;
    global_plan_live_clock = p.live_clock;
}

static Plan readPlan(time_t now)
{
    Plan p;
    auto &nvs = NVSManager::getInstance();
    uint8_t u8 = 1;
    nvs.getU8("profile", u8, 1); p.profile = (u8 > 3) ? 1 : u8;

    // Presets, overridden by whatever the user actually saved. Custom has no preset of its own and
    // falls back to Optimal until its own values are stored.
    static const uint32_t SCD_DEF[3]  = { 5, 15, 30 };
    static const uint32_t WIFI_DEF[3] = { 15, 30, 0 };
    const uint8_t pidx = (p.profile <= 2) ? p.profile : 1;
    uint32_t s_int = SCD_DEF[pidx], w_int = WIFI_DEF[pidx];
    nvs.getU32("s_int", s_int, s_int);
    nvs.getU32("w_int", w_int, w_int);
    uint32_t s_night = s_int * 2;             // at night, half as often unless told otherwise
    nvs.getU32("s_int_n", s_night, s_night);

    uint8_t nm_en = 1, nm_sh = 23, nm_eh = 7;
    nvs.getU8("nm_en", nm_en, 1);
    nvs.getU8("nm_sh", nm_sh, 23);
    nvs.getU8("nm_eh", nm_eh, 7);
    // Night mode used to be forced on in Ultra Save, on the belief that it was "essential to reach
    // the long battery life". Measured 2026-09-21 with the rebuilt model, it is worth 5 % there and
    // nothing else: Ultra already has no live clock and no scheduled radio, so the only thing night
    // still does is double the CO2 interval — 30 minutes to 60. That is eight fewer single shots a
    // day, almost entirely the SCD41's own charge. Five per cent is not worth an overnight reading
    // that can be an hour old, and it is certainly not worth deciding for the owner. The other
    // profiles keep the same switch they always had; this only stops one of them overriding it.

    float tz = 0; nvs.getFloat("tz_h", tz, 0.0f);
    if (nm_en && now > 1600000000) {
        int h = (int)(((now + (time_t)(tz * 3600)) / 3600) % 24);
        if (h < 0) h += 24;
        p.night = inNight(h, nm_sh, nm_eh);
    }

    // A device the owner set up without Wi-Fi never raises its radio: there is nothing to fetch,
    // nowhere to publish and nobody to notify. It also happens to be the longest-lived
    // configuration this device has, since the radio is its largest single expense.
    //
    // This has to happen BEFORE radio_min is derived, and it did not. The interval was zeroed
    // afterwards, so p.offline came out right while p.radio_min kept the profile's default — and
    // radio_min is what the schedule actually reads. An offline device therefore went on planning
    // sessions, and since the network name left over from the failed join is still in NVS, it went
    // on trying to join it. The one configuration advertised as the longest-lived was the shortest.
    uint8_t no_wifi = 0; nvs.getU8("no_wifi", no_wifi, 0);
    // Matter mode keeps its radio for Thread: there is no scheduled Wi-Fi window at all, so for the
    // schedule, the screen and the alerting it is a device without a network (owner, 2026-09-16:
    // weather is lost in this mode). Its console sessions are raised by the button, not by the plan.
    { uint8_t wl = 0; nvs.getU8("wl_mode", wl, 0); p.matter = (wl == 2); }
    if (p.matter) no_wifi = 1;
    if (no_wifi) w_int = 0;
    // Kept apart from `offline` below, which is also true for Ultra Save. For the screen
    // the two are the same — no outdoor weather either way — but for alerting they are
    // opposites: Ultra Save has a network and simply does not use it on a schedule, so an
    // event may still raise the radio; this one has nowhere to send anything, ever.
    p.no_net = (no_wifi != 0);
    // A hub that is told once and never again is worse than no hub: Home Assistant shows the
    // reading from the moment of setup for ever, with no indication it has stopped. Ultra Save and
    // a Custom interval of zero both do exactly that, because discovery goes out on the first
    // session and nothing schedules a second. So in hub mode the radio keeps a floor — an hour is
    // still eight sessions a day less than Optimal, and it is the difference between a live sensor
    // and a dead one.
    { uint8_t wl = 0; nvs.getU8("wl_mode", wl, 0);
      if (wl == 1 && !p.no_net && w_int == 0) w_int = 60; }

    p.meas_min  = p.night ? s_night : s_int;
    if (p.meas_min < 1) p.meas_min = 1;
    p.radio_min = p.night ? 0 : w_int;        // the radio sleeps through the night in every profile
    // Zero stays zero (radio off); anything else gets a floor, because storage may already hold a
    // value written before the interval was clamped at the API, and this one turns straight into
    // how often the device transmits.
    if (p.radio_min != 0 && p.radio_min < 5) p.radio_min = 5;
    // Night silences the radio too, but only until morning — that is not the same thing. This is
    // about the profile: with the interval set to zero the device will never go online at all, so
    // there is no outdoor weather to show and the screen should stop reserving room for it.
    p.offline   = (w_int == 0);

    uint8_t live = 1; nvs.getU8("live_clk", live, 1);
    if (p.profile == 2) live = 0;             // Ultra Save shows the time of the last reading
    p.live_clock = live && !p.night;          // at night the moon replaces the clock (CLAUDE.md 4.14)
    return p;
}

// Whether the device is in its night window. Published so the hub can tell a sleeping device from
// a broken one — the radio is off all night in every profile, and a rule watching for silence
// would otherwise report a fault every single night.
bool device_is_night() { return readPlan(time(NULL)).night; }

// Has the owner finished setting this device up?
//
// Not the same question as "is it on a network", and conflating the two is what made a device with
// no Wi-Fi useless. CO2, temperature, humidity, the log and the whole screen need no network at
// all; only the clock, the outdoor weather and the hub do. Somebody with a 5 GHz-only router, a
// corporate network, or no Wi-Fi whatsoever bought a CO2 monitor and is entitled to a CO2 monitor.
//
// So there are two ways to be set up: a network that has actually been joined, or a deliberate
// choice to run without one. Both are the owner saying "I am done"; neither is a guess.
bool device_configured()
{
    std::string ssid;
    uint8_t ok = 0, offline = 0, prov = 0;
    NVSManager::getInstance().getString("ssid", ssid, "");
    NVSManager::getInstance().getU8("wifi_ok", ok, 0);
    NVSManager::getInstance().getU8("no_wifi", offline, 0);
    NVSManager::getInstance().getU8("provisioned", prov, 0);
    // A device that has been set up before and now has a network name it has not joined yet — the
    // owner typed a new one, or a typo — is still set up. It runs its cycle, shows that the network
    // is unreachable and lets a long press open its own access point to fix it. Treating it as new
    // sent a working installation back to the logo, asleep until somebody pressed the button.
    const bool joined = !ssid.empty() && (ok || prov);
    // Choosing Matter in the console is the third way of being done: the device then pairs itself
    // with a smart home and needs no Wi-Fi to work.
    return joined || offline || MatterMode::selected();
}

// Reads the night back out of the history ring. Called once, when night ends.
static void summarise_night(time_t now, time_t started)
{
    struct Acc { uint32_t n, co2sum, co2max; float tmin, tmax, hmax; } a =
        { 0, 0, 0, 999.0f, -999.0f, 0.0f };
    HistStore::getInstance().init();
    HistStore::getInstance().query((uint32_t)started, (uint32_t)now, 600,
        [](const HistRec &r, void *ctx) {
            Acc *x = (Acc *)ctx;
            if (r.co2 == 0) return;                       // a record with no CO2 reading
            x->n++; x->co2sum += r.co2;
            if (r.co2 > x->co2max) x->co2max = r.co2;
            const float t = r.temp_d / 10.0f;
            if (t < x->tmin) x->tmin = t;
            if (t > x->tmax) x->tmax = t;
            if (r.hum > x->hmax) x->hmax = r.hum;
        }, &a);

    if (a.n < 3) { rtc_ns_from = rtc_ns_to = 0; ESP_LOGW(TAG, "night summary: too few records"); return; }
    rtc_ns_co2_max = (uint16_t)a.co2max;
    rtc_ns_co2_avg = (uint16_t)(a.co2sum / a.n);
    rtc_ns_t_min = a.tmin; rtc_ns_t_max = a.tmax; rtc_ns_h_max = a.hmax;
    rtc_ns_from = (uint32_t)started; rtc_ns_to = (uint32_t)now;
    ESP_LOGW(TAG, "night summary from %u readings: CO2 peak %u, average %u, %.1f-%.1f C, up to %.0f %%",
             (unsigned)a.n, (unsigned)rtc_ns_co2_max, (unsigned)rtc_ns_co2_avg,
             rtc_ns_t_min, rtc_ns_t_max, rtc_ns_h_max);
}

// Handed to the payload builder in another file.
uint16_t night_co2_max() { return rtc_ns_co2_max; }
uint16_t night_co2_avg() { return rtc_ns_co2_avg; }
float    night_t_min()   { return rtc_ns_t_min; }
float    night_t_max()   { return rtc_ns_t_max; }
float    night_h_max()   { return rtc_ns_h_max; }
bool     night_valid()   { return rtc_ns_from != 0 && rtc_ns_to != 0; }


// Is the cell too low to keep working? Read the gauge and nothing else — this runs before the
// sensors, the radio or the screen, because the whole point is to stop spending what is left.
//
// The threshold is the regulator's, not a preference: below it the 3.3 V rail can no longer be
// held and the device would brown out mid-write. Coming back out needs a clear margin above it,
// or the reading would flap as the load comes and goes.
static bool battery_too_low(bool may_read)
{
    // On a minute tick the cached voltage is enough: a cell that was above the threshold sixty
    // seconds ago has not crossed it since, and bringing the I2C bus up to confirm costs more
    // than the answer is worth. The gauge is read on measurement ticks, which is also when its
    // reading is wanted for everything else.
    // One threshold for both paths, clamped where it is read: a stored value can predate the clamp in
    // /api/save, and the two paths used to disagree about it.
    // Built in rather than stored (battery_spec.h): this is the only software guard the cell has,
    // and on the v2 board, with the fuel gauge gone, it will be the only guard at all.
    const float lowv = BATTERY_CUTOFF_V;
    if (!may_read) {
        // The cable is checked here too, and it has to be: the rule below is "on the cable the
        // charger is in charge", but it lived only in the path that reads the gauge. So a device
        // already locked out, then plugged in, kept answering "locked" on every minute tick — and
        // sleep_low_battery() arms "wake when the cable goes in" on a cable that is ALREADY in,
        // which fires the instant it sleeps. The device then booted and slept in a tight loop until
        // the next gas measurement came due and the reading path released it: up to five minutes of
        // continuous wakes, on a nearly flat cell, drawing nothing and explaining nothing. Reading
        // one pin costs a gpio_config(); it is the cheapest thing in this function.
        if (rtc_lockout && usb_present()) {
            rtc_lockout = false; rtc_lock_drawn = false;
            ESP_LOGW(TAG, "charger connected — releasing the low-battery lockout");
            return false;
        }
        if (rtc_volt > 2.0f && !rtc_lockout && rtc_volt < lowv) rtc_lockout = true;
        return rtc_lockout;
    }

    I2CManager::getInstance().init();
    i2c_master_bus_handle_t bus = I2CManager::getInstance().getBusHandle();
    // Whether a charger is attached does not depend on the gauge answering, and it is the only way
    // out of lockout. Both failure paths below used to return before that check, so a device that
    // had correctly locked out and then lost its gauge stayed locked out FOR EVER: every hourly
    // wake took the early return and slept again — no screen, no radio, no console, and the button
    // could not help either, because this runs before all of them. Plugging in the charger did
    // nothing. The only way out was pulling the cell to force a power loss. It needs a second,
    // independent fault to reach, which is exactly when a device must not become unrecoverable.
    auto charger_escape = []() {
        if (!usb_present()) return false;
        rtc_lockout = false; rtc_lock_drawn = false;
        ESP_LOGW(TAG, "battery unreadable but the charger is connected — releasing lockout");
        return true;
    };
    if (!bus) {                                   // cannot tell: keep whatever we decided before
        if (charger_escape()) return false;
        return rtc_lockout;
    }

    // Whichever way this board reads its cell — gauge on v1, divider on v2. The guard itself is
    // unchanged by the revision: it compares volts to a built-in threshold and needs no percent.
    float v = 0;
    if (!BatterySource::readVoltage(bus, v) || v < 2.0f) {
        if (charger_escape()) return false;
        return rtc_lockout;
    }
    rtc_volt = v;

    // On the cable the charger is in charge; never lock out while it can recover on its own.
    if (usb_present()) { rtc_lockout = false; rtc_lock_drawn = false; return false; }

    if (!rtc_lockout && v < lowv)          { rtc_lockout = true;  ESP_LOGE(TAG, "battery %.3f V below %.2f V — locking out", v, lowv);
        // Both directions, because the pair is the evidence: a lockout with no matching release is
        // a device that stopped, and the voltage at each edge says whether the threshold or the
        // gauge was at fault.
        EvtLog::getInstance().event(EVT_POWER, (uint32_t)lroundf(v * 1000.0f) | 0x10000u); }
    else if (rtc_lockout && v > lowv + 0.15f) { rtc_lockout = false; rtc_lock_drawn = false; ESP_LOGW(TAG, "battery recovered to %.3f V — resuming", v);
        EvtLog::getInstance().event(EVT_POWER, (uint32_t)lroundf(v * 1000.0f)); }
    return rtc_lockout;
}

// ---- the working cycle, in the order the user asked for --------------------------------------
// wake -> sensors (I2C brought up and parked again afterwards) -> internet (time, then weather)
// -> ONE screen draw with everything -> sleep. Drawing last is the point: the screen should never
// show half the story while the rest is still arriving.

// Is the cable in? Read the pin rather than the fuel gauge's charge rate: after every boot the
// gauge reports nonsense for a while (a charge of +17 %/h with nothing plugged in has been seen),
// and each tick here IS a fresh boot. The pin is honest on this board revision (CLAUDE.md 4).
// Handed to the installer so it does not open I2C a second time in the same wake just to find out
// whether it may spend the charge. Both are readings this cycle has already taken.
extern "C" float smart_meteo_soc(void)  { return rtc_soc; }
extern "C" bool  smart_meteo_on_usb(void) { return usb_present(); }

static bool usb_present(void)
{
    gpio_config_t io = {};
    io.pin_bit_mask = (1ULL << PIN_USB_DETECT);
    io.mode = GPIO_MODE_INPUT;
    gpio_config(&io);
    return gpio_get_level(PIN_USB_DETECT) == 0;
}
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
