SmartMeteo/smartmeteo/(commit log)

2026-11-04 Smart Meteo: firmware, enclosure and tools
    An indoor climate monitor on the ESP32-C6 with a 4.2" e-ink screen, a Sensirion SCD41 and
    a Bosch BME690: Wi-Fi, MQTT with Home Assistant discovery, or Matter over Thread.
    - firmware/: the ESP-IDF project (v5.5.2 + esp-matter); builds without Bosch BSEC, which
    is not redistributable (firmware/components/bsec2/README.md says how to add it).
    - hardware/enclosure/: Fusion generator scripts, STL for PLA and resin, STEP.
    - artwork/: the weather icons and the scripts that turn the pictures into firmware data.
    Firmware Apache-2.0, hardware CERN-OHL-P-2.0, documentation CC BY-SA 4.0; third-party
    parts in NOTICE.md.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
    [front_shell.step, front_shell.stl, jig_base.stl, jig_lid.stl, key.step, key.stl, key_c010.step, key_c010.stl]
2026-11-05 Board v2.2: schematic, BOM and Gerber files
    The board the enclosure is designed for (silkscreen "SmartMeteo v2.2"):
    ESP32-C6-WROOM-1-N8, SCD41, BME690, TP4056, battery voltage on a divider,
    no fuel gauge. Pin map and build notes in hardware/board-v2/README.md.
    Also: tests/shot_guide.js finds the console cards that moved tabs.
    [SmartMeteo-v2.2_BOM.csv]
